josephsvk/IOT_LC_PROTOTYPE_V1/README.md

# IOT_LC_PROTOTYPE_V1

## Requirements typically met:

	- USB Pair > 92.51 ohm Zd
	- AC insulation using 2 mm cutouts in the board; the rest is 3 mm , OVC III, PD2
	- Option to install two different 24V power sources
	- Properly designed GND boards and VIAS , zone minimum width 0.3 mm
	- The area under the antenna connector has been cleaned
	-

Modular IoT controller — custom PCB hardware project designed in KiCad 10.

**Status:** Work in progress — prototype, not validated for production.

This repository contains the KiCad schematic, PCB layout, design rules, and generated technical documentation.

> **Safety:** The design includes mains-voltage circuitry. It has not been certified or validated for safe mains operation. Do not assume that the published design is safe to manufacture or energize.

## Project Files

- `IOT_LC_PROTOTYPE_V1.kicad_pro` — KiCad project configuration
- `IOT_LC_PROTOTYPE_V1.kicad_sch` — Main schematic
- `IOT_LC_PROTOTYPE_V1.kicad_pcb` — PCB layout
- `IOT_LC_PROTOTYPE_V1.kicad_dru` — Custom design rules
- `*.kicad_sch` — Hierarchical schematic sheets

## Automation Scripts

### `scripts/export-pdf.sh`

Generates vector PDF documentation and PNG previews for this README.

```bash
./scripts/export-pdf.sh
```

Requirements: KiCad CLI 10 and `poppler-utils`.

### `scripts/auto-git.sh`

Automatically commits saved project changes and pushes them to GitHub.

- Runs through a local systemd user timer.
- Checks for changes approximately every 15 minutes.
- Respects `.gitignore`.
- Creates commits only when changes exist.
- Does not use force push.

The timer is configured locally and is not installed automatically when cloning this repository.

## Documentation

PDF and PNG files in `docs/` are generated from the KiCad source files.

The README displays PNG previews. The linked PDF files provide vector-quality documentation.

## License

No license has been specified. All rights reserved unless a license is added.

<!-- AUTO-DOCS-START -->
## Schematic documentation

### Complete active hierarchical schematic

**Page 1**

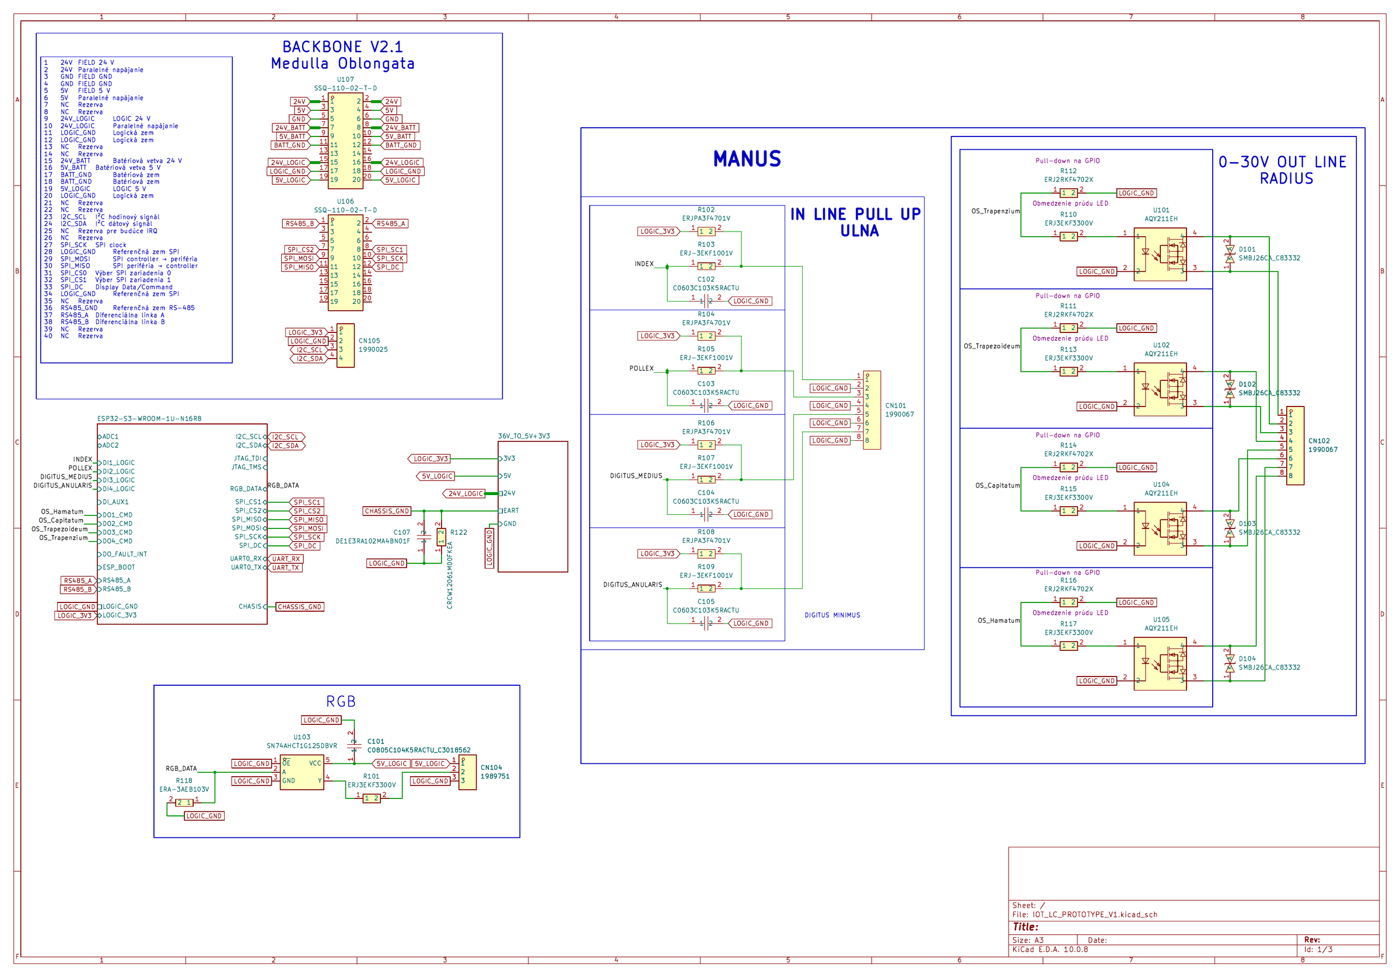
[picture p1: docs/images/schematic-001.png]
Complete active hierarchical schematic — page 1


**Page 2**

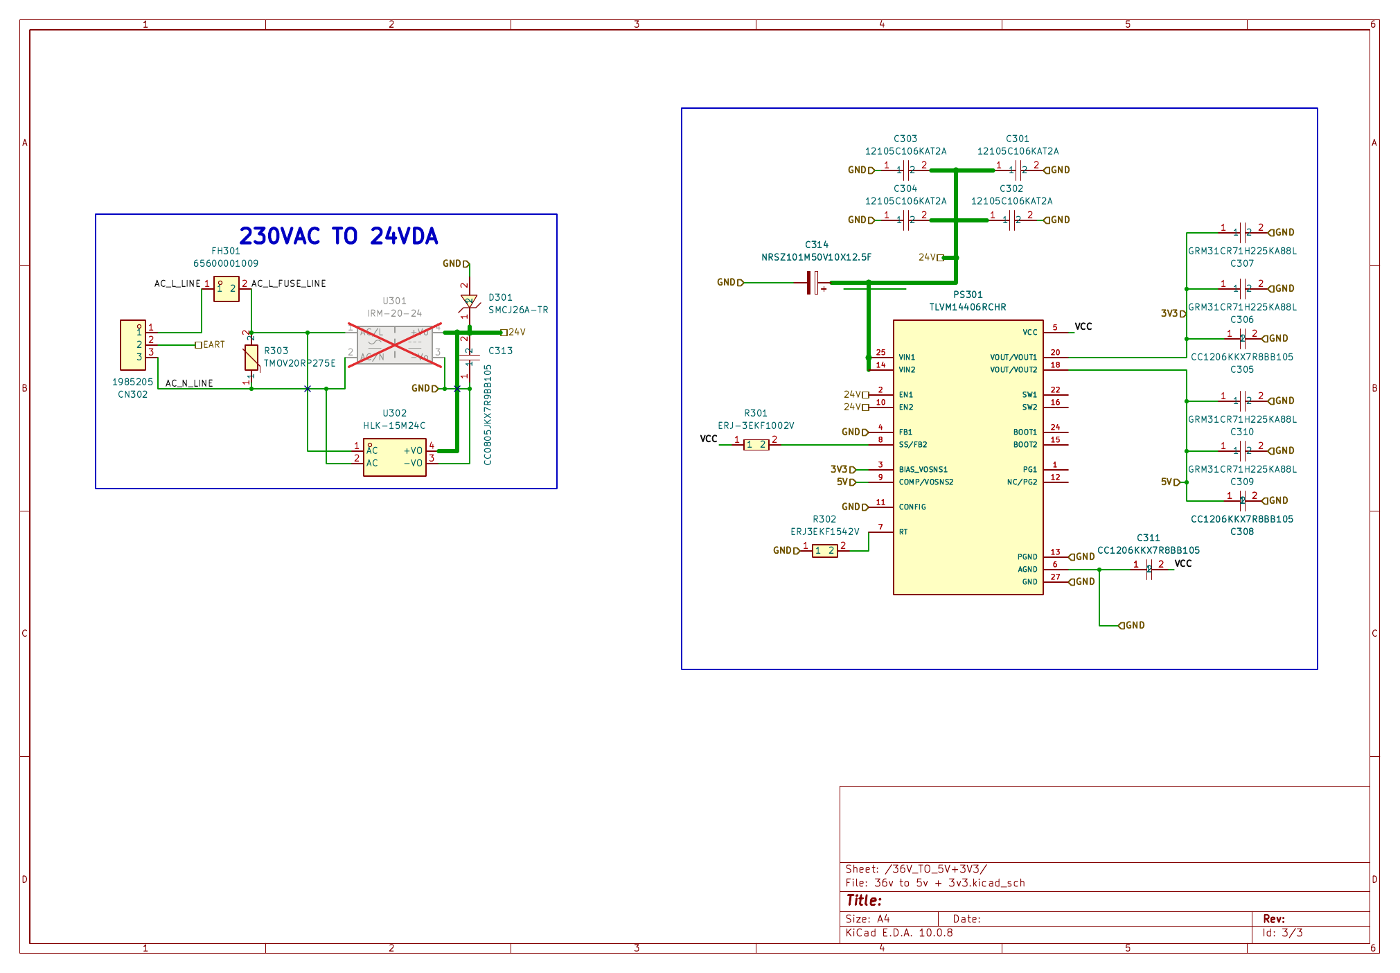
[picture p2: docs/images/schematic-002.png]
Complete active hierarchical schematic — page 2


**Page 3**

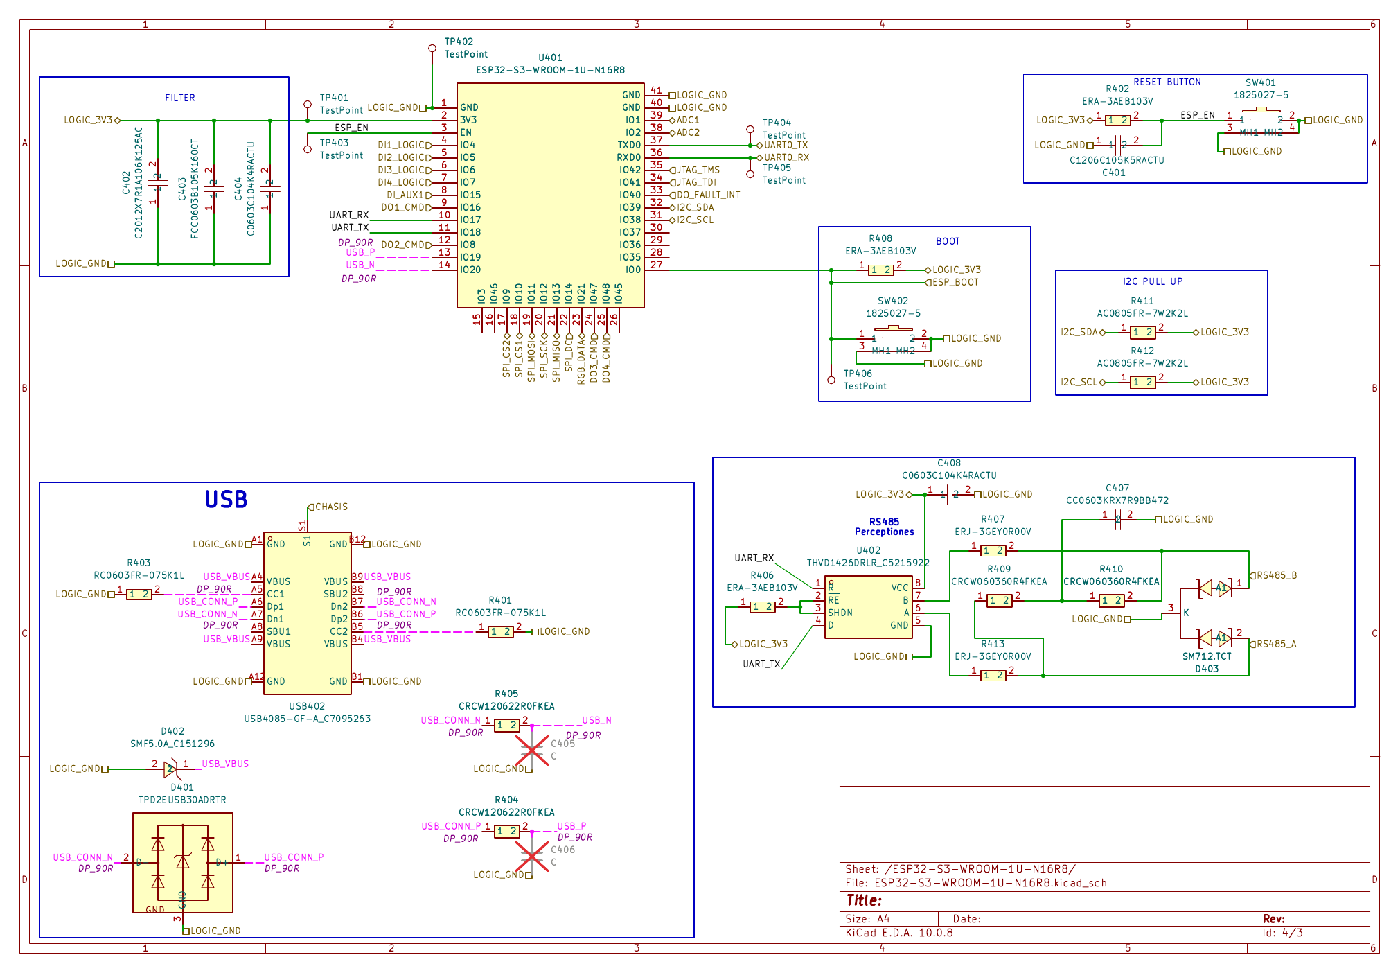
[picture p3: docs/images/schematic-003.png]
Complete active hierarchical schematic — page 3


[View vector PDF](docs/pdf/schematic.pdf)

## PCB documentation

### PCB front

**Page 1**

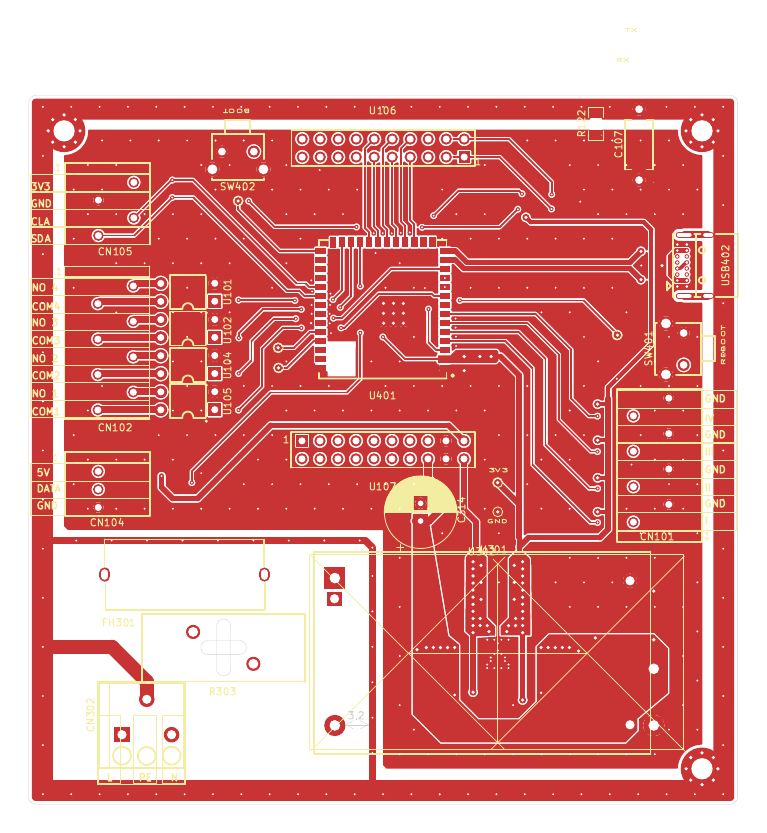
[picture p4: docs/images/pcb-front-001.png]
PCB front — page 1


[View vector PDF](docs/pdf/pcb-front.pdf)

### PCB back

**Page 1**

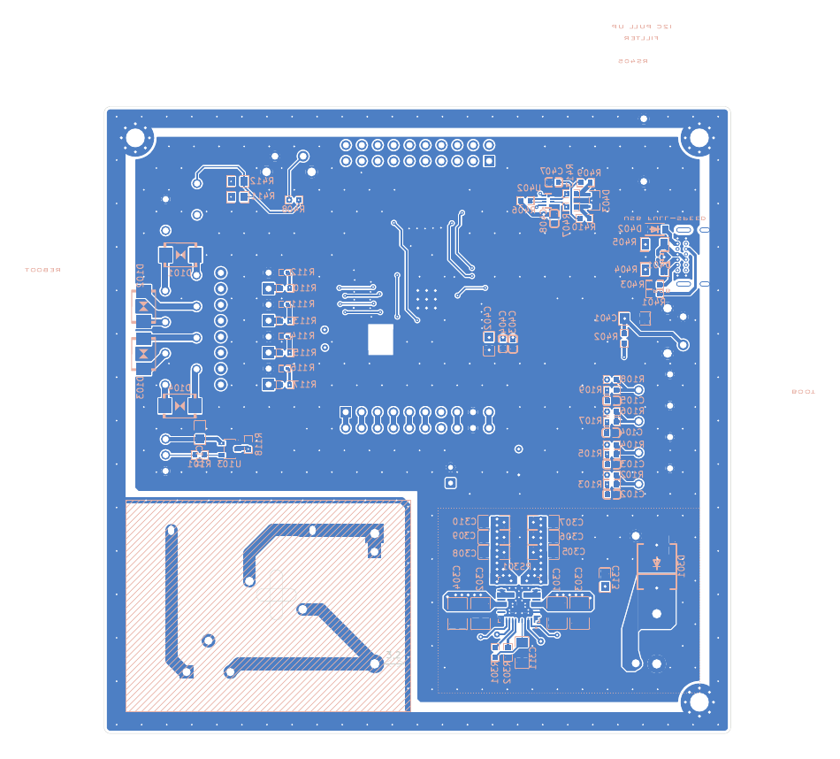
[picture p5: docs/images/pcb-back-001.png]
PCB back — page 1


[View vector PDF](docs/pdf/pcb-back.pdf)

### Individual PCB layers

**Page 1**

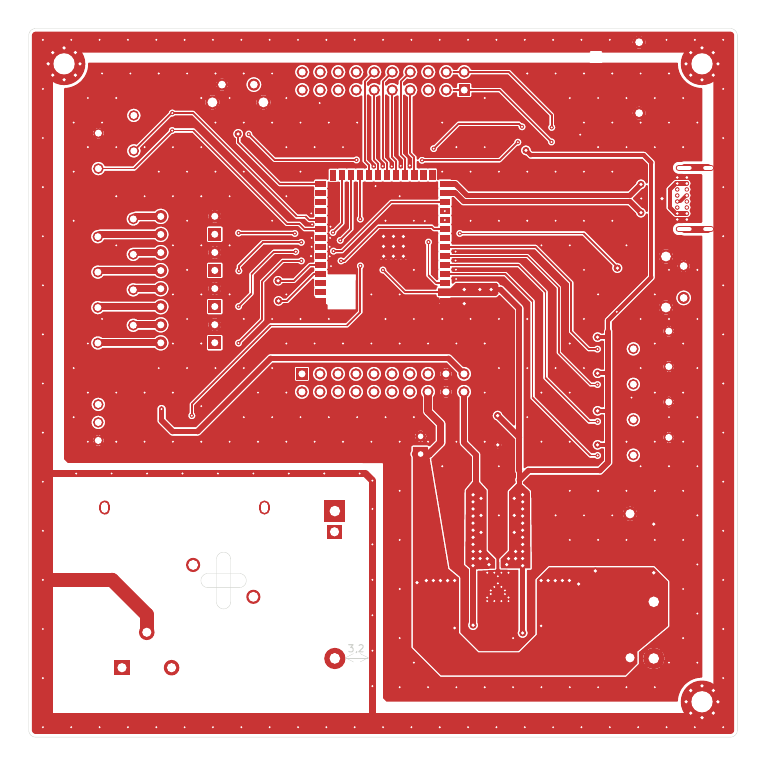
[picture p6: docs/images/pcb-layers-001.png]
Individual PCB layers — page 1


**Page 2**

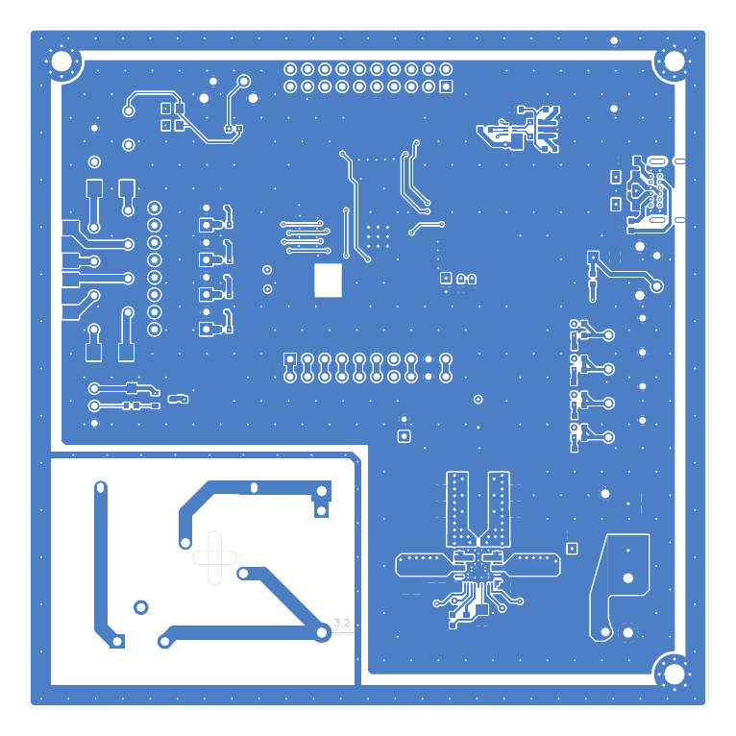
[picture p7: docs/images/pcb-layers-002.png]
Individual PCB layers — page 2


**Page 3**

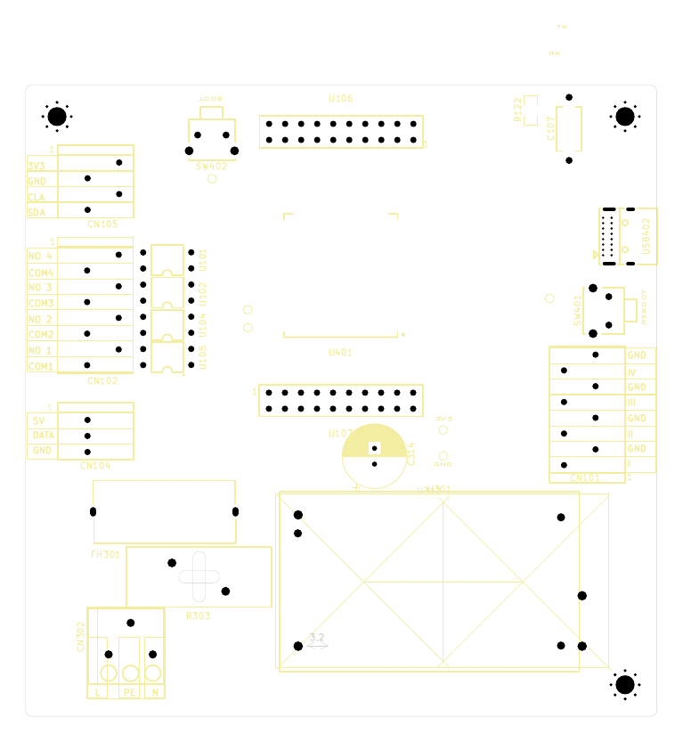
[picture p8: docs/images/pcb-layers-003.png]
Individual PCB layers — page 3


**Page 4**

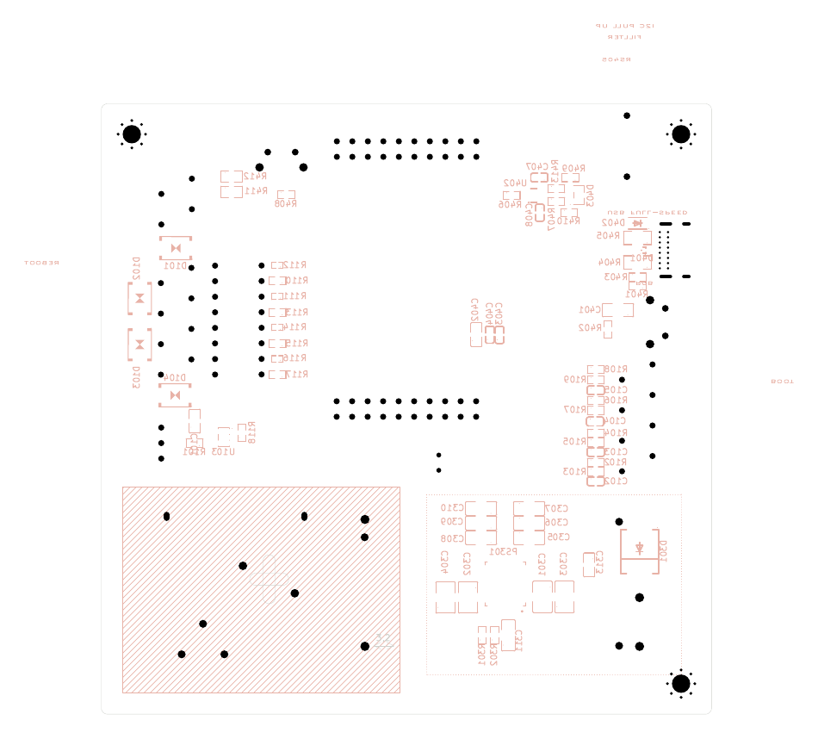
[picture p9: docs/images/pcb-layers-004.png]
Individual PCB layers — page 4


[View vector PDF](docs/pdf/pcb-layers.pdf)
<!-- AUTO-DOCS-END -->
