josephsvk/IOT_LC_PROTOTYPE_V1/pcbway_production/2026-11-04-19-17-19/IOT_LC_PROTOTYPE_V1.kicad_pcb_bom.csv

Designator | Quantity | Value | Footprint | Package | MPN | DNP | Mount_Type | LCSC Part | Manufacturer | Description | MF | MAXIMUM_PACKAGE_HEIGHT | CREATOR | Price | Check_prices | STANDARD | PARTREV | SnapEDA_Link | MP | Availability | MANUFACTURER | label | Label
C101 | 1 | C0805C104K5RACTU_C3018562 | C0805 |  | C0805C104K5RACTU |  | smt | C3018562 | KEMET(基美)
C102, C103, C104, C105 | 4 | C0603C103K5RACTU | C0603 |  | C0603C103K5RACTU |  | smt | C116378 | KEMET(基美)
C301, C302, C303, C304 | 4 | 12105C106KAT2A | C1210 |  | 12105C106KAT2A |  | smt | C597580 | Kyocera AVX
C305, C308, C311 | 3 | CC1206KKX7R8BB105 | C1206 |  | CC1206KKX7R8BB105 |  | tht | C107184 | YAGEO(国巨)
C306, C307, C309, C310 | 4 | GRM31CR71H225KA88L | C1206 |  | GRM31CR71H225KA88L |  | tht | C77095 | muRata(村田) | 2.2uF (225) ±10% 50V
C313 | 1 | CC0805JKX7R9BB105 | C0805 |  | CC0805JKX7R9BB105 |  | smt | C541528 | YAGEO(国巨)
C314 | 1 | NRSZ101M50V10X12.5F | CP_Radial_D10.0mm_P2.50mm |  |  |  | tht |  |  | THT Electrolytic Capacitor, Horizontal Mounting, 12.5mm Diameter, 5.00mm Pitch, 25.0mm Height, European Symbol, Alternate KiCad Library
C401 | 1 | C1206C105K5RACTU | C1206 |  | C1206C105K5RACTU |  | smt | C2167287 | KEMET(基美)
C402 | 1 | C2012X7R1A106K125AC | C0805 |  | C2012X7R1A106K125AC |  | smt | C2167452 | TDK
C403 | 1 | FCC0603B105K160CT | C0603 |  | FCC0603B105K160CT |  | tht | C7419418 | FOJAN(富捷)
C404 | 1 | C0603C104K4RACTU | C0603 |  | C0603C104K4RACTU |  | tht | C2181816 | KEMET(基美)
CN101, CN102 | 2 | 1990067 | CONN-TH_8P-P2.50_1990067 |  | 1990067 |  | tht | C17327671 | Phoenix Contact(菲尼克斯)
CN104 | 1 | 1989751 | CONN-TH_3P-P2.50_1989751 |  | 1989751 |  | tht | C17585029 | Phoenix Contact(菲尼克斯)
CN301 | 1 | 1792876 | CONN-TH_1792876 |  | 1792876 |  | tht | C5482625 | Phoenix Contact(菲尼克斯)
D101, D102, D103, D104 | 4 | SMBJ26CA_C83332 | SMB_L4.6-W3.6-LS5.3-BI |  | SMBJ26CA |  | smt | C83332 | Littelfuse(美国力特)
D301 | 1 | SMCJ26A-TR | SMC_L7.1-W6.2-LS8.1-RD |  | SMCJ26A-TR |  | smt | C133649 | ST(意法半导体)
D401 | 1 | TPD2EUSB30ADRTR | SOT-9X3-3_L1.0-W0.8-P0.35-LS1.0-BR |  | TPD2EUSB30ADRTR |  | smt | C94934 | TI(德州仪器)
D402 | 1 | SMF5.0A_C151296 | SOD-123F_L2.8-W1.8-LS3.7-RD |  | SMF5.0A |  | smt | C151296 | Littelfuse(美国力特)
FH301 | 1 | 65600001009 | FUSE-TH_65600001009 |  | 65600001009 |  | tht | C187510 | Littelfuse(美国力特)
H101 | 1 | M20-6102045 | HDR-TH_40P-P2.54-V-F-R2-C20-S2.54 |  | M20-6102045 |  | tht | C5160231 | Harwin
PS301 | 1 | TLVM14406RCHR | CONV_TLVM14406RCHR | None |  |  | smt |  |  | Non-Isolated PoL Module DC DC Converter 2 Output 0.8 ~ 9V 3A, 3A 3V - 36V Input | Texas Instruments | 2.10mm | NEZY | None | https://www.snapeda.com/parts/TLVM14406RCHR/Texas+Instruments/view-part/?ref=eda | Manufacturer Recommendations | July 2024 | https://www.snapeda.com/parts/TLVM14406RCHR/Texas+Instruments/view-part/?ref=snap | TLVM14406RCHR | In Stock | Texas Instruments
R101, R110, R113, R115, R117 | 5 | ERJ3EKF3300V | R0603 |  | ERJ3EKF3300V |  | smt | C278617 | PANASONIC(松下) |  |  |  |  |  |  |  |  |  |  |  |  | Obmedzenie prúdu LED
R103, R105, R107, R109 | 4 | ERJ-3EKF1001V | R0603 |  | ERJ3EKF1001V |  | smt | C118155 | PANASONIC(松下)
R111, R112, R114, R116 | 4 | ERJ2RKF4702X | R0402 |  | ERJ2RKF4702X |  | smt | C413103 | PANASONIC(松下) |  |  |  |  |  |  |  |  |  |  |  |  | Pull-down na GPIO
R118, R402, R406, R408 | 4 | ERA-3AEB103V | R0603 |  | ERA3AEB103V |  | smt | C190610 | PANASONIC(松下)
R301 | 1 | ERJ-3EKF1002V | R0603 |  | ERJ3EKF1002V |  | smt | C191124 | PANASONIC(松下)
R302 | 1 | ERJ3EKF1542V | R0603 |  | ERJ3EKF1542V |  | smt | C402999 | PANASONIC(松下)
R303 | 1 | TMOV20RP275E | RES-TH_L23.0-W9.5-P8.50-D0.9-S4.50 |  | TMOV20RP275E |  | tht | C187710 | Littelfuse(美国力特)
R401, R403 | 2 | RC0603FR-075K1L | R0603 |  | RC0603FR-075K1L |  | smt | C105580 | YAGEO(国巨)
R404, R405 | 2 | CRCW120622R0FKEA | R1206 |  | CRCW120622R0FKEA |  | tht | C844425 | VISHAY(威世)
R407, R409, R410 | 3 | ERJ-3GEY0R00V | R0603 |  | ERJ3GEY0R00V |  | smt | C122704 | PANASONIC(松下)
R411, R412 | 2 | AC0805FR-7W2K2L | R0805 |  | AC0805FR-7W2K2L |  | smt | C5545398 | YAGEO(国巨)
SW401, SW402 | 2 | 1825027-5 | KEY-TH_4P-L7.5-W6.8-P4.50-LS7.2 |  | 1825027-5 |  | tht | C86476 | TE Connectivity(泰科电子)
TP401, TP402, TP403, TP404, TP405, TP406 | 6 | TestPoint | TestPoint_Pad_D1.0mm |  |  |  | tht |  |  | test point |  |  |  |  |  |  |  |  |  |  |  | GND | [TP401]3V3; [TP403]EN; [TP404]UART0_TX; [TP405]UART0_RX; [TP406]BOOT
U101, U102, U104, U105 | 4 | AQY211EH | DIP-4_L6.4-W4.8-P2.54-LS7.6-BL |  | AQY211EH |  | smt | C719541 | PANASONIC(松下)
U103 | 1 | SN74AHCT1G125DBVR | SOT-23-5_L3.0-W1.7-P0.95-LS2.8-BR |  | SN74AHCT1G125DBVR |  | smt | C7484 | TI(德州仪器)
U302 | 1 | HLK-15M24C | PWRM-TH_4P-L47.5-W28.5_HLK-15MXXC |  | HLK-15M24C |  | tht | C18203066 | HI-LINK(海凌科)
U401 | 1 | ESP32-S3-WROOM-1U-N16R8 | WIRELM-SMD_ESP32-S3-WROOM-1U |  | ESP32-S3-WROOM-1U-N16R8 |  | smt | C3013946 | ESPRESSIF(乐鑫)
U403 | 1 | THVD1450DGKR | VSSOP-8_L3.0-W3.0-P0.65-LS4.9-BL |  | THVD1450DGKR |  | smt | C2860896 | TI(德州仪器)
USB402 | 1 | USB4085-GF-A_C7095263 | USC-C-SMD_USB4085-GF-A |  | USB4085-GF-A |  | tht | C7095263 | GCT
