josephsvk/IOT_LC_PROTOTYPE_V1/IOT_LC_PROTOTYPE_V1-Edge_Cuts.dxf

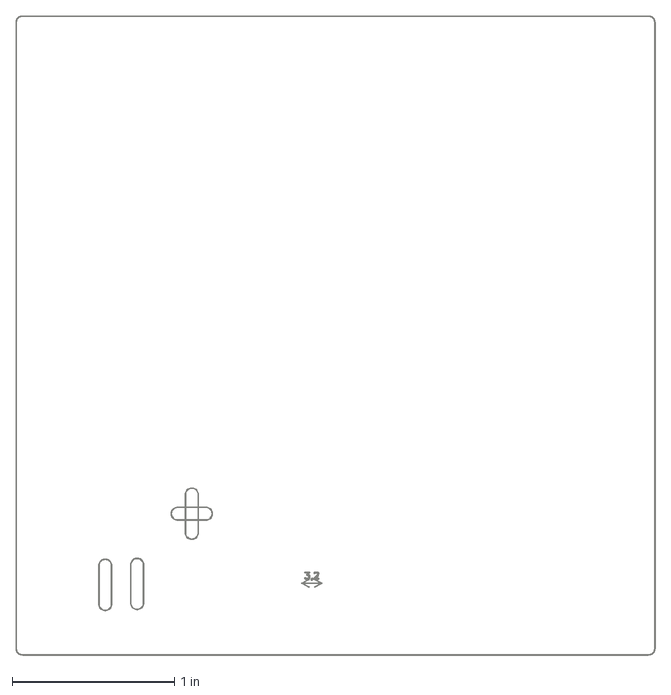
[picture p10: CAD file, 2026-11-07]
IOT_LC_PROTOTYPE_V1-Edge_Cuts.dxf
3.94 x 3.94 in
