josephsvk/IOT_LC_PROTOTYPE_V1/IOT_LC_PROTOTYPE_V1-B_Cu.dxf

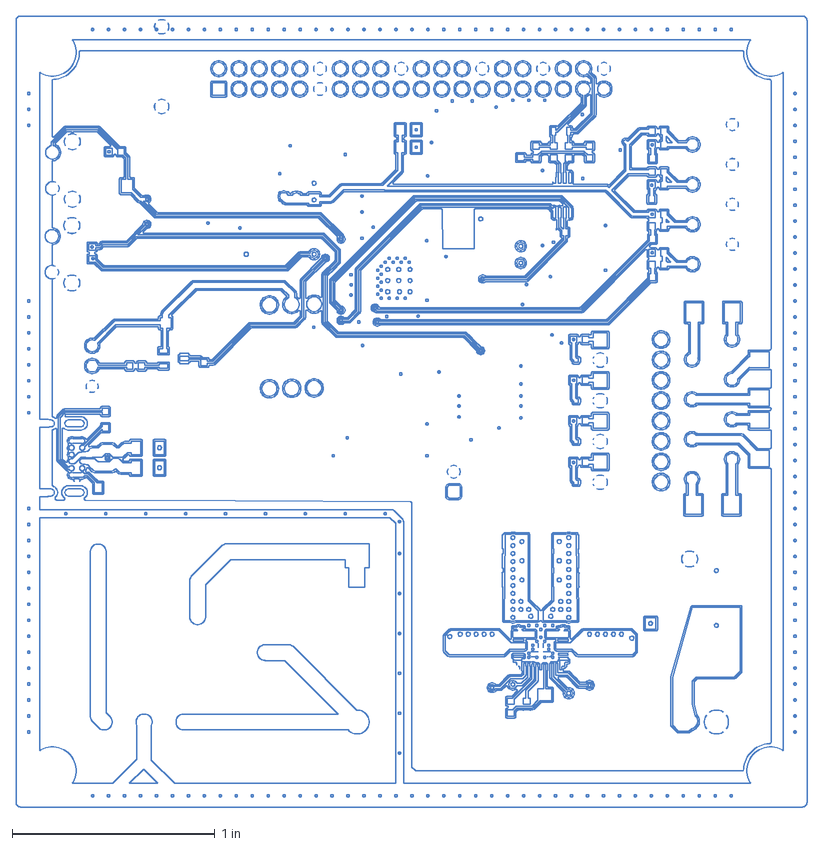
[picture p11: CAD file, 2026-11-07]
IOT_LC_PROTOTYPE_V1-B_Cu.dxf
3.90 x 3.90 in
