josephsvk/IOT_LC_PROTOTYPE_V1/IOT_LC_PROTOTYPE_V1-F_Cu.dxf

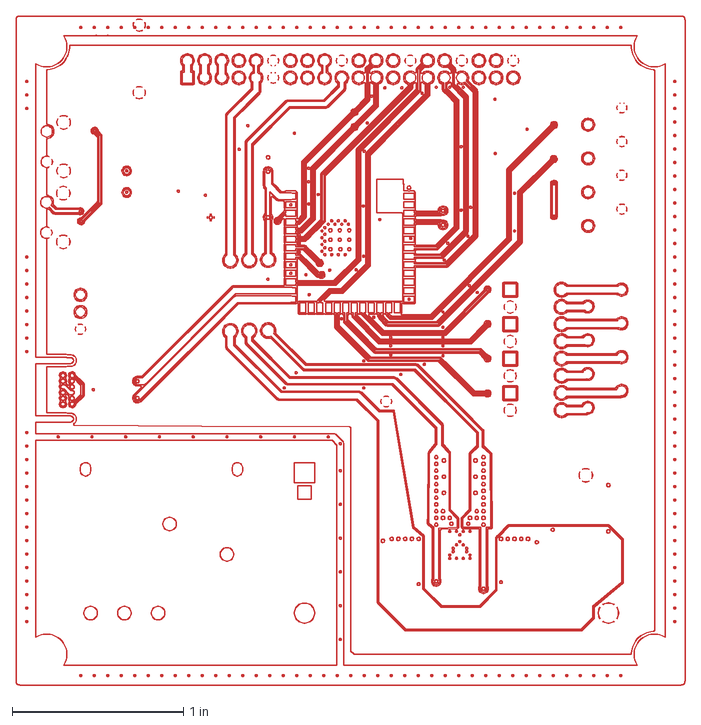
[picture p12: CAD file, 2026-11-07]
IOT_LC_PROTOTYPE_V1-F_Cu.dxf
3.90 x 3.90 in
