josephsvk/IOT_LC_PROTOTYPE_V1/docs/pdf/schematic.pdf

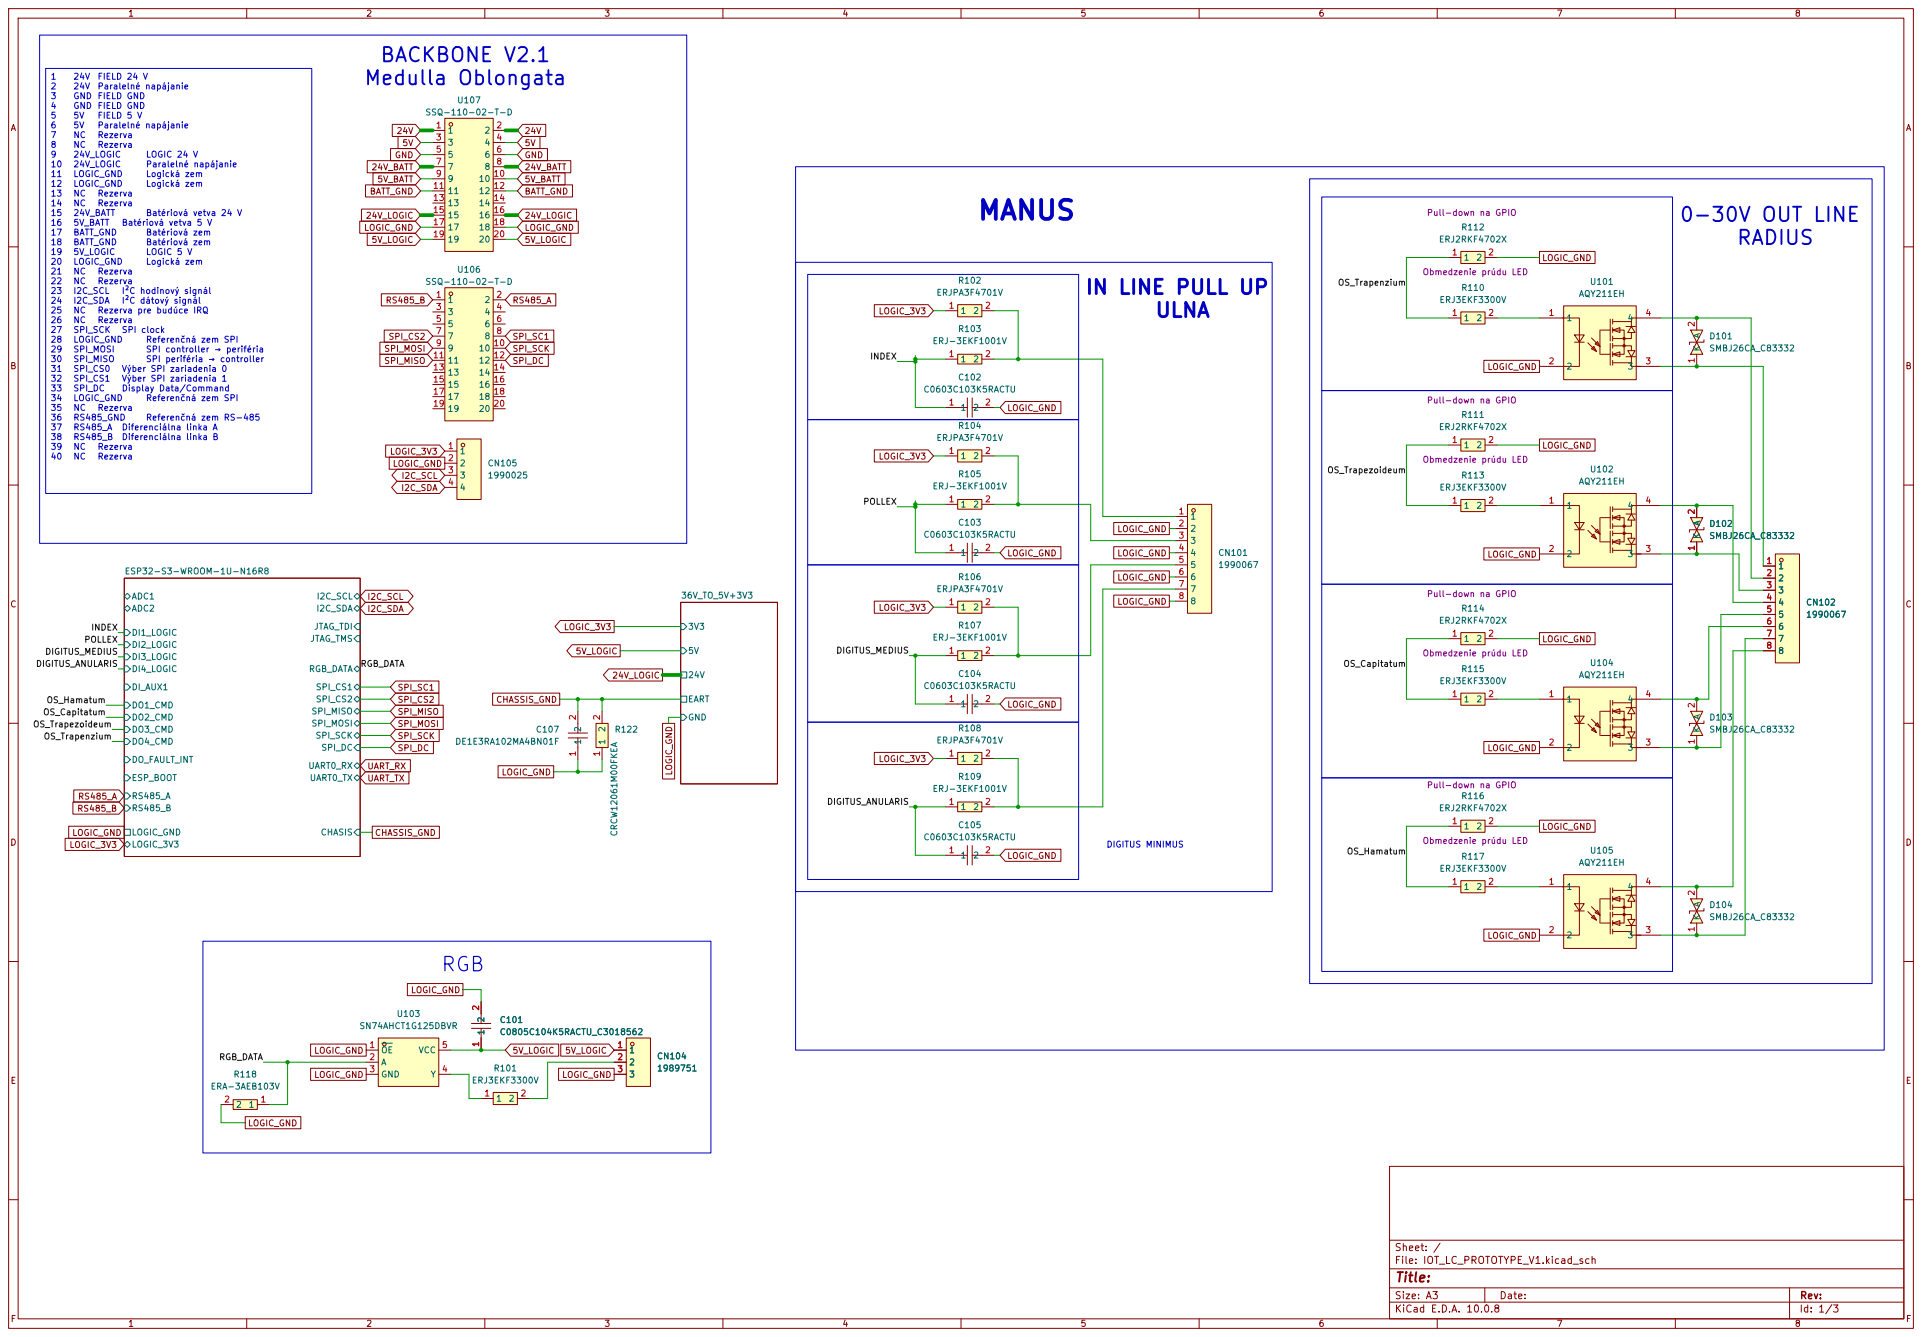
[picture p13: page 1]

ERJ2RKF4702X Pull-down na GPIO

IN LINE PULL UP

37 RS485_A Diferenciálna linka A 38 RS485_B Diferenciálna linka B

Size: A3 | Rev: | F Date:
KiCad E.D.A. 10.0.8 | Id: 1/3

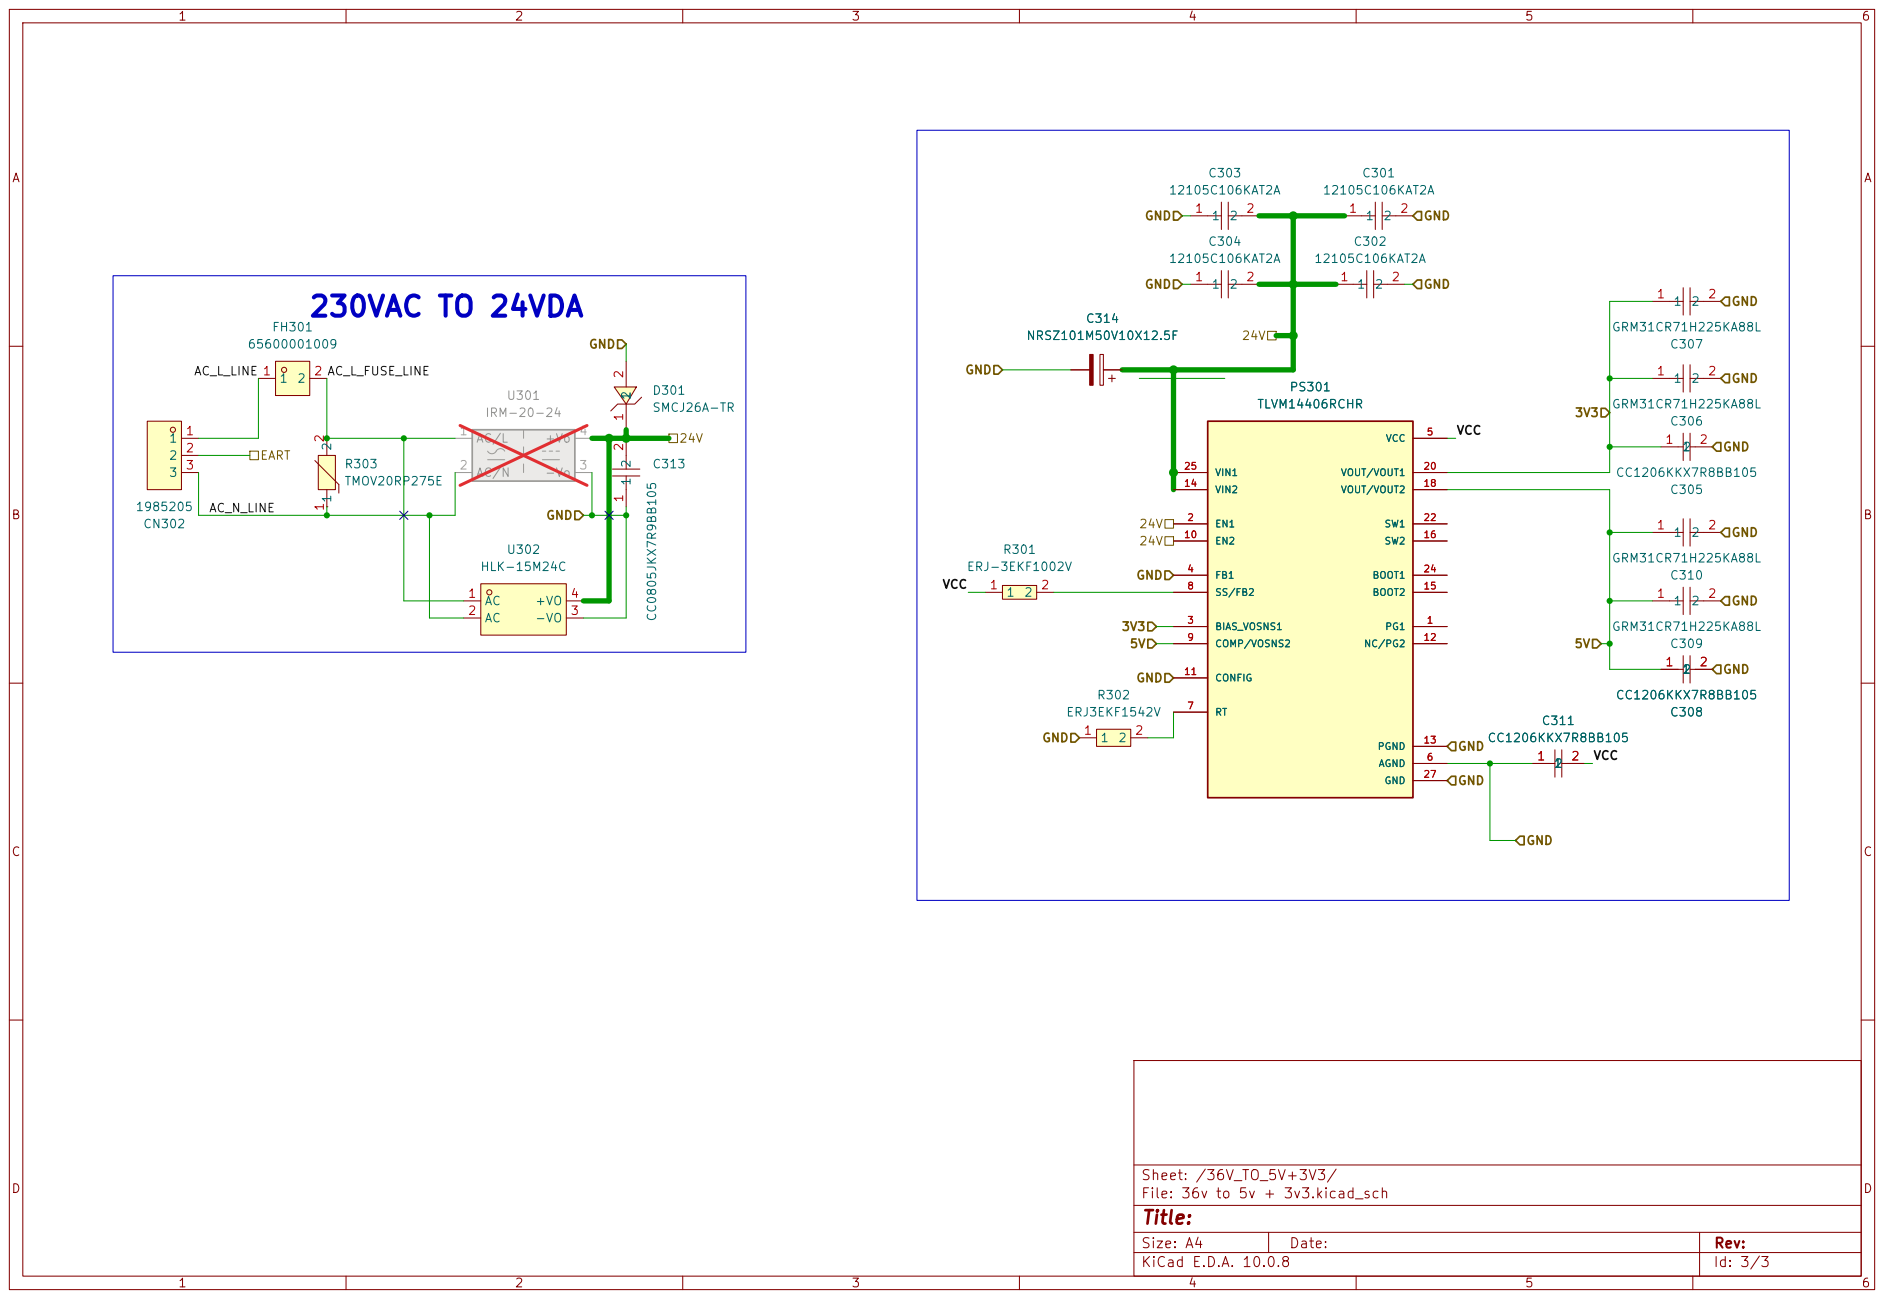
[picture p14: page 2]

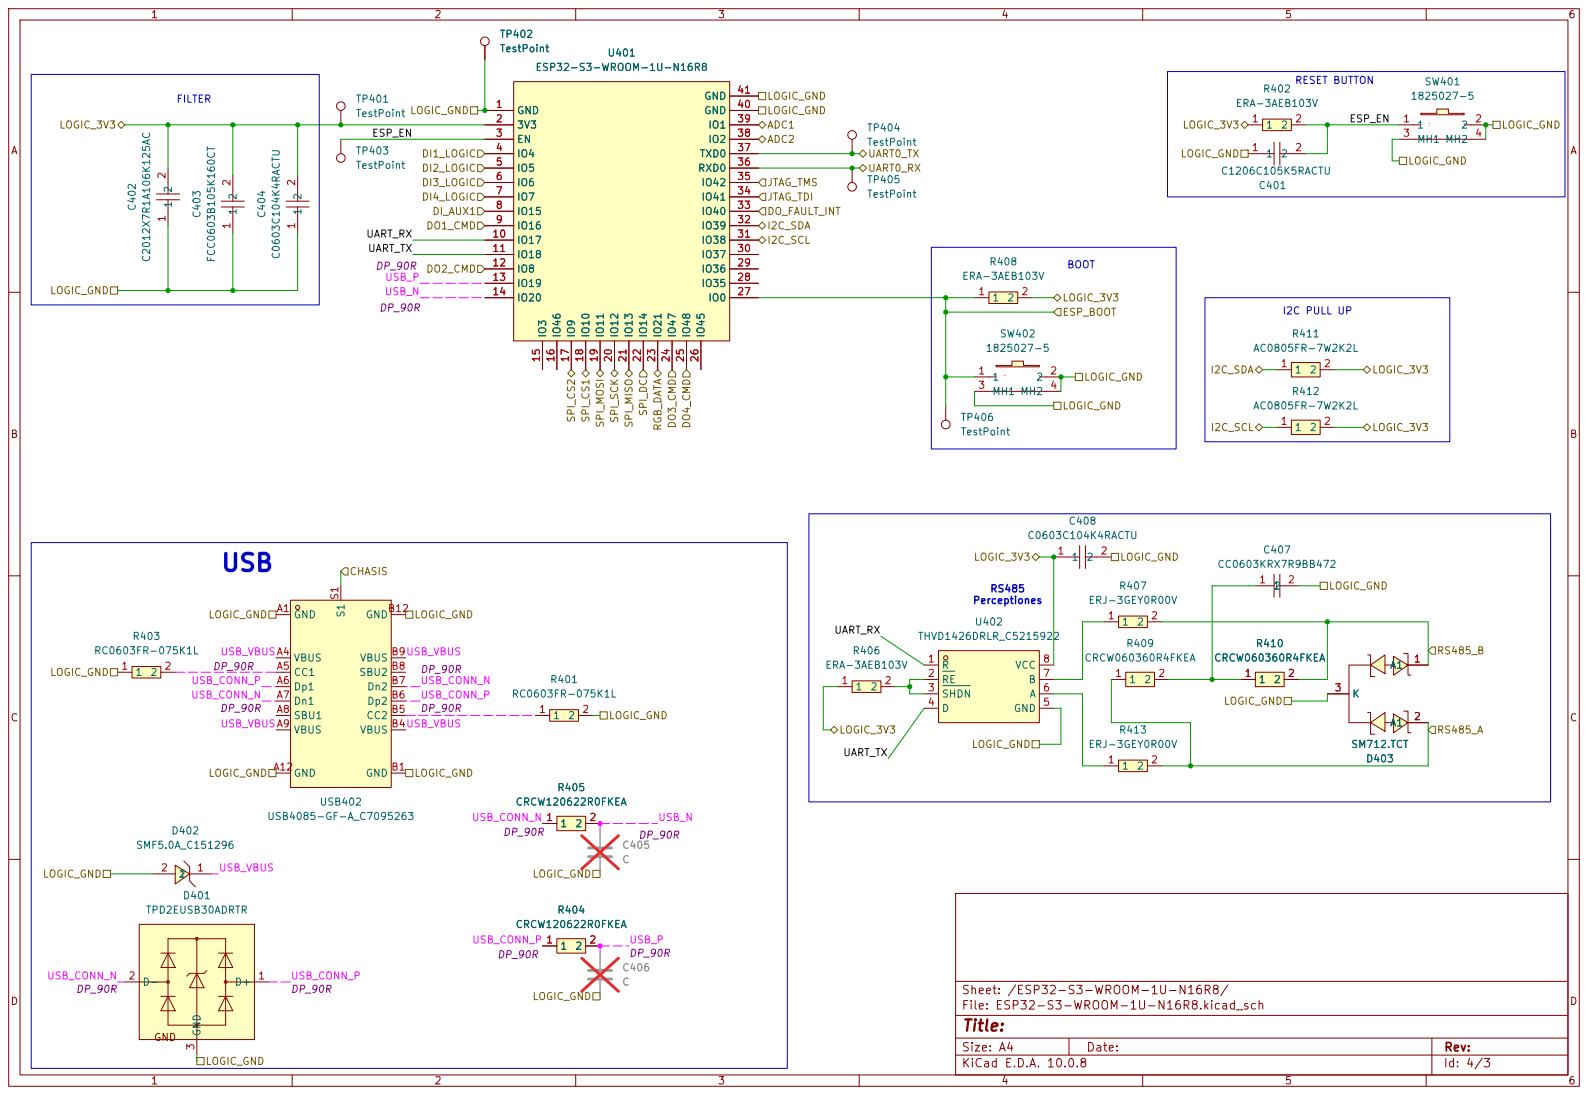
[picture p15: page 3]

2 C408 C0603C104K4RACTU

2 R410 CRCW060360R4FKEA | 3 R410 CRCW060360R4FKEA 1
