josephsvk/IOT_LC_PROTOTYPE_V1/docs/pdf/pcb-front.pdf

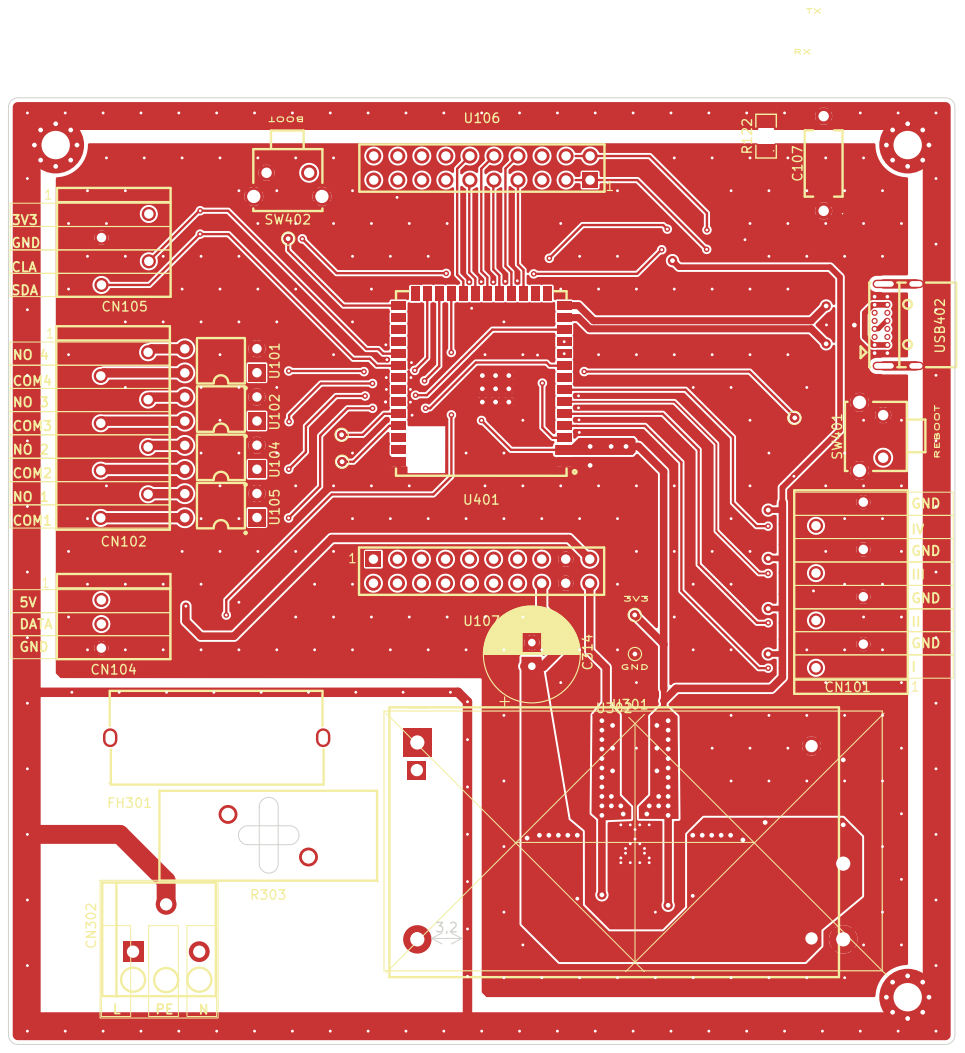
[picture p16: page 1]

3V3 NO 4 COM4 NO 3 COM3 NO 2 COM2 NO 1 COM1

GND

IVGND

III GND
