josephsvk/IOT_LC_PROTOTYPE_V1/docs/pdf/pcb-layers.pdf

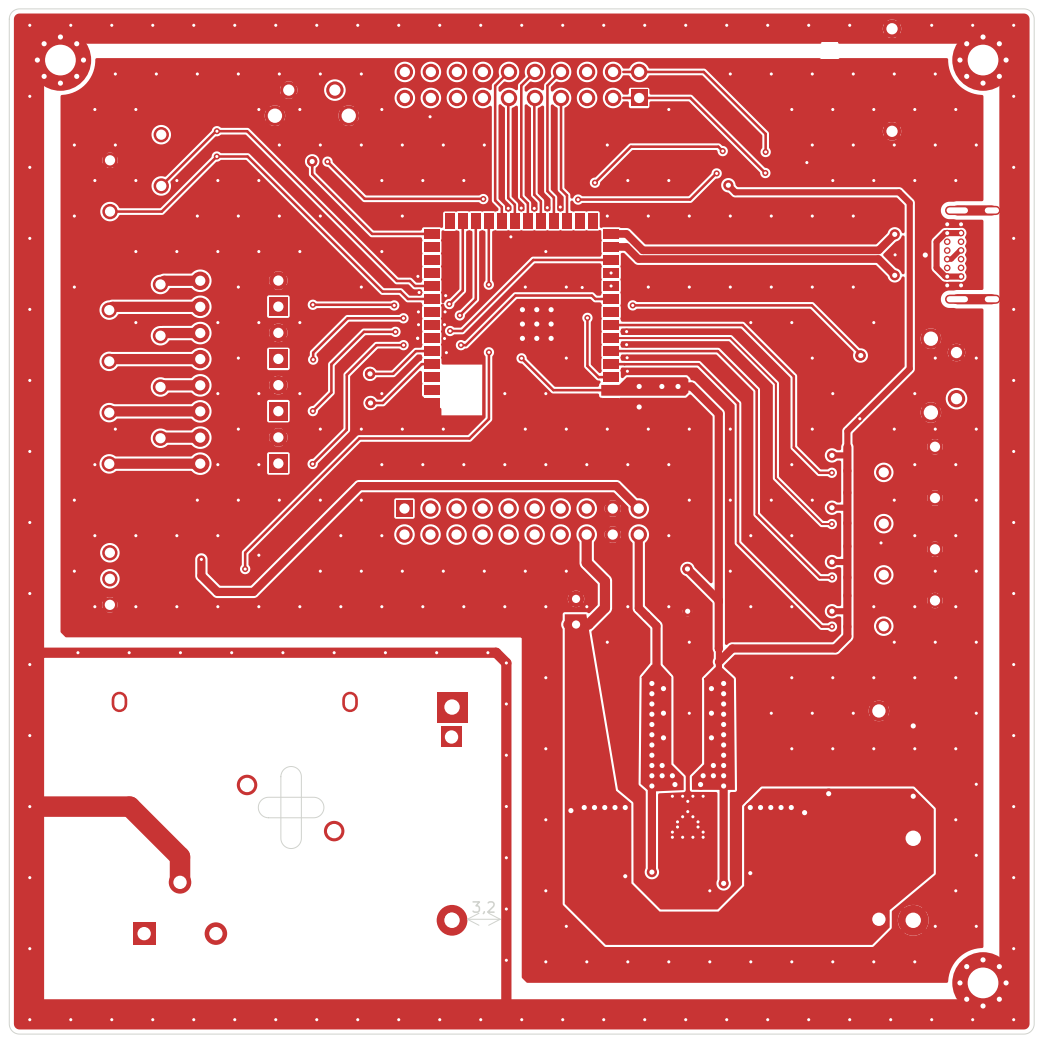
[picture p17: page 1]

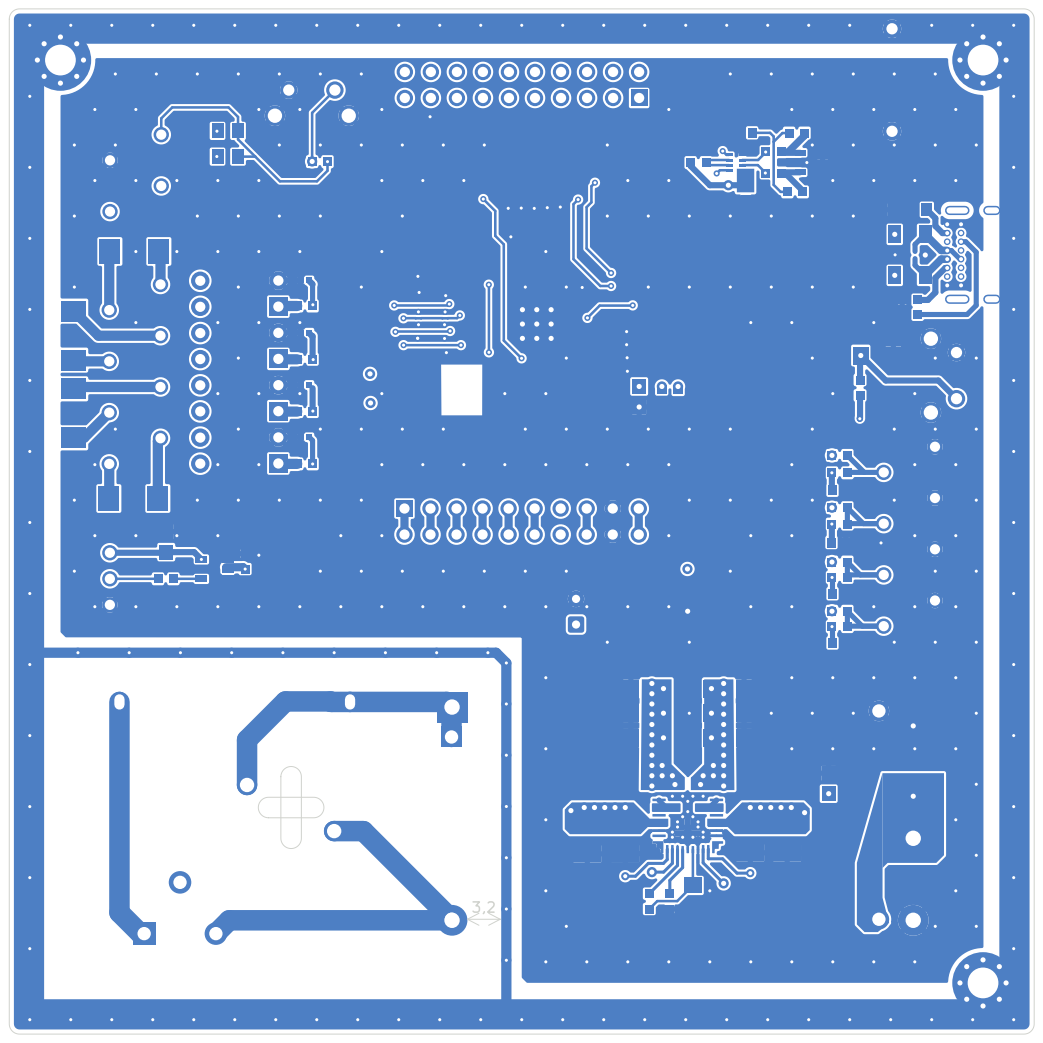
[picture p18: page 2]

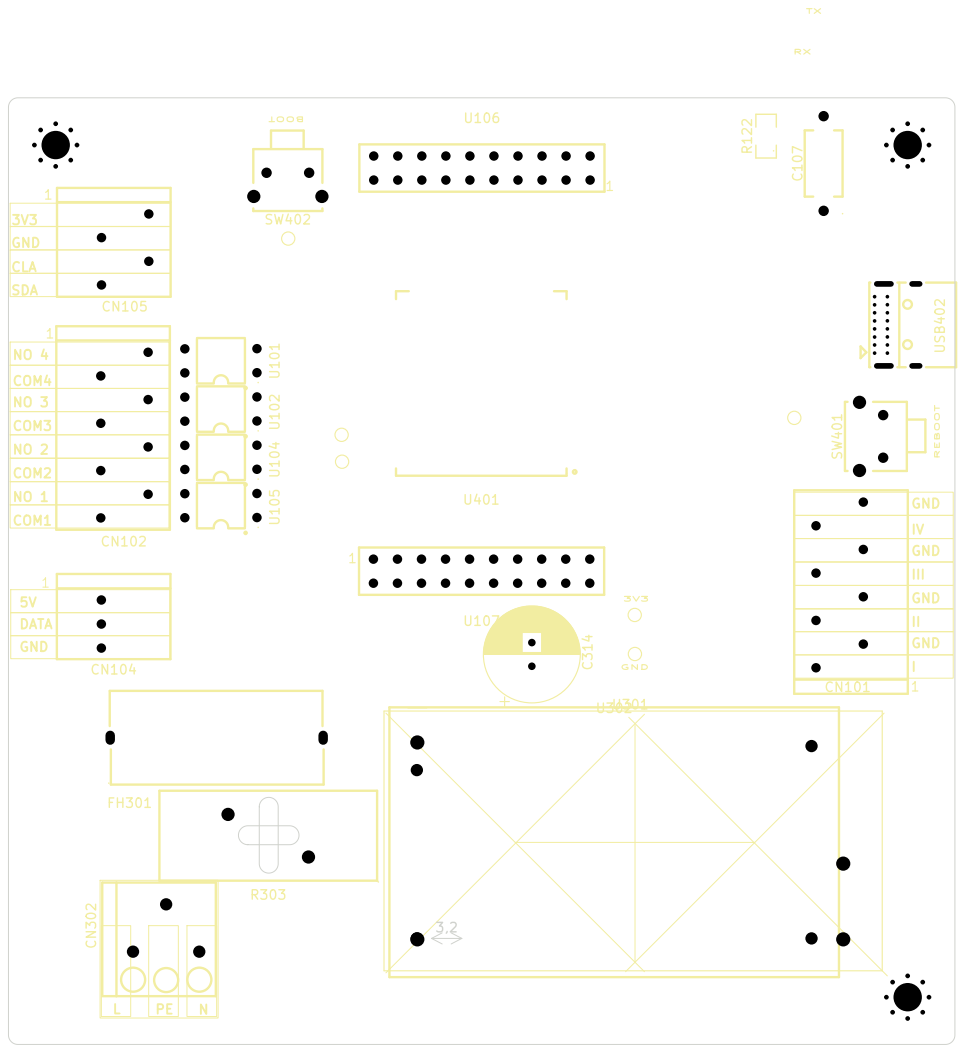
[picture p19: page 3]

3V3 NO 4 COM4 NO 3 COM3 NO 2 COM2 NO 1 COM1

GND

IVGND

III GND

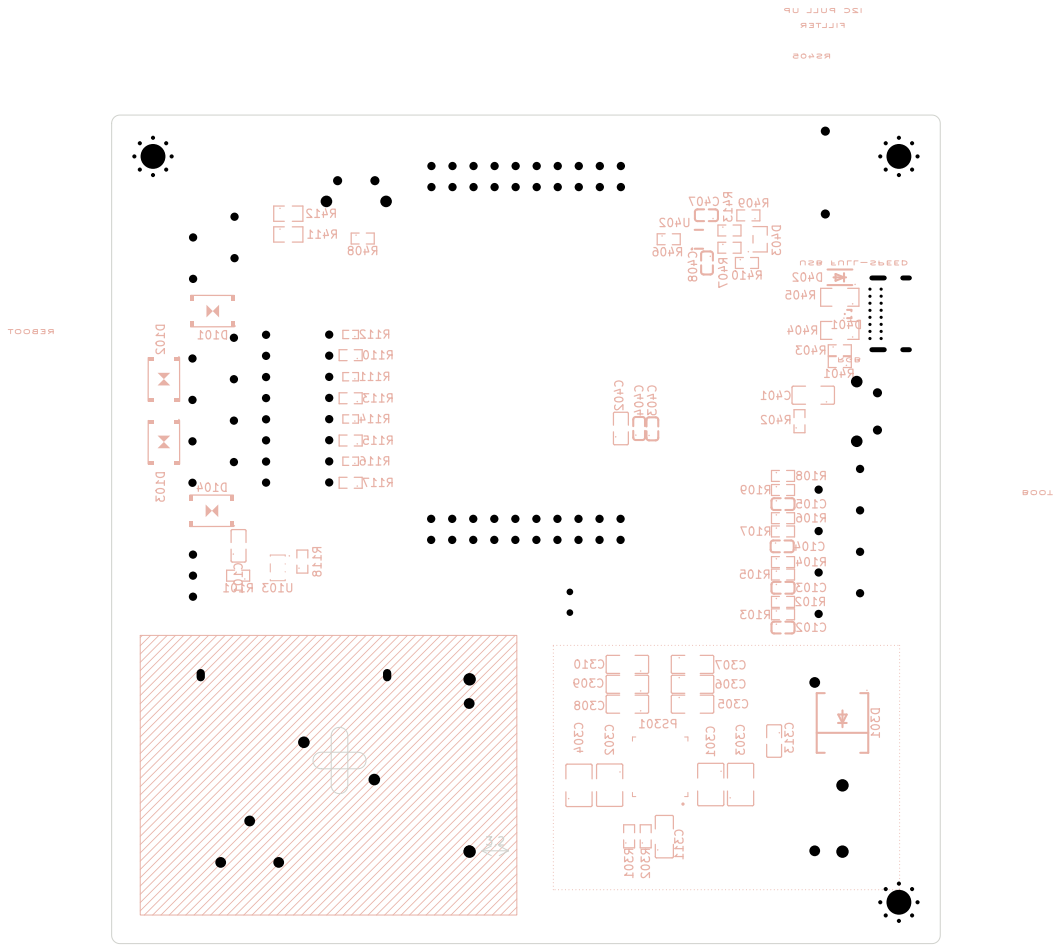
[picture p20: page 4]
