josephsvk/IOT_LC_PROTOTYPE_V1/IOT_LC_PROTOTYPE_V1-B_Cu.pdf

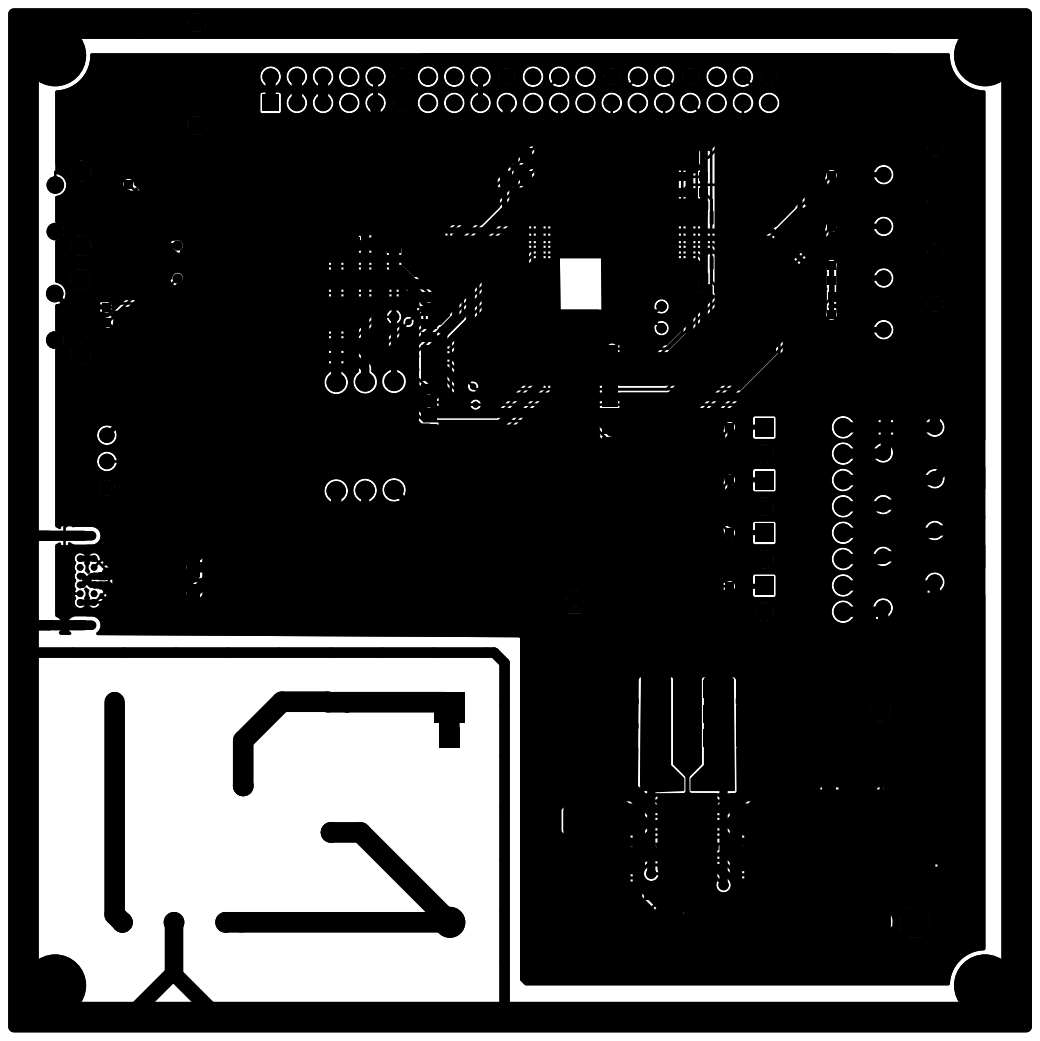
[picture p21: page 1]
