josephsvk/IOT_LC_PROTOTYPE_V1/IOT_LC_PROTOTYPE_V1-Edge_Cuts.pdf

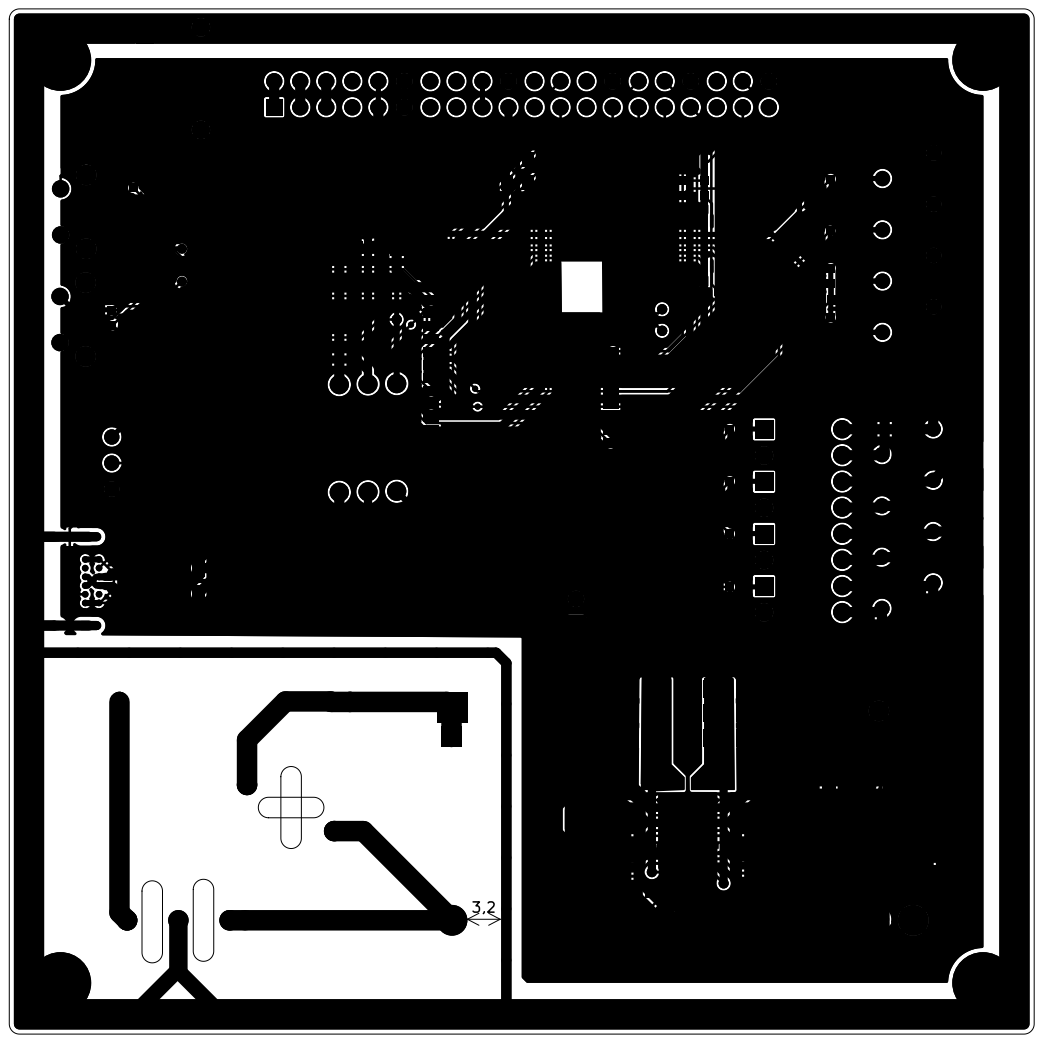
[picture p22: page 1]
