josephsvk/IOT_LC_PROTOTYPE_V1/IOT_LC_PROTOTYPE_V1-F_Cu.pdf

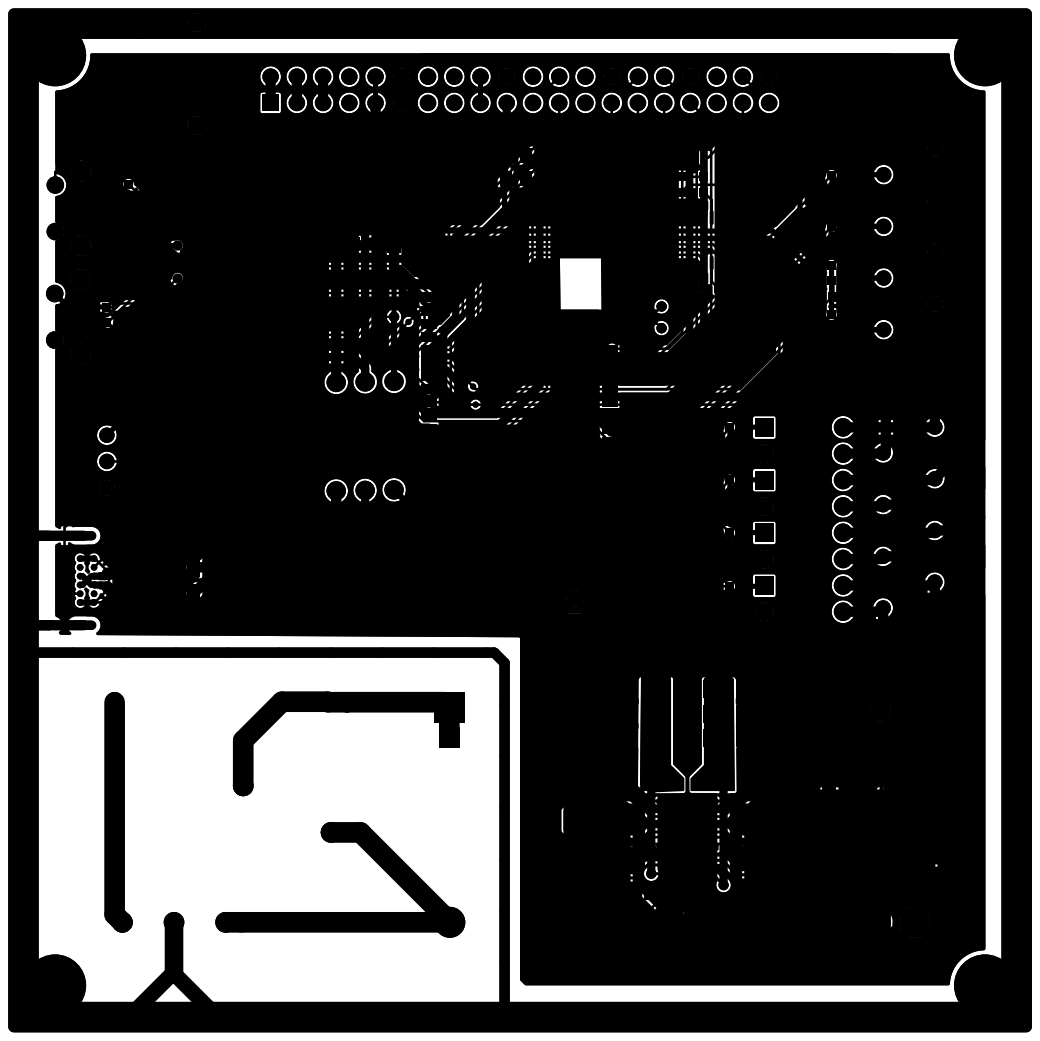
[picture p23: page 1]
