josephsvk/IOT_LC_PROTOTYPE_V1/docs/pdf/pcb-back.pdf

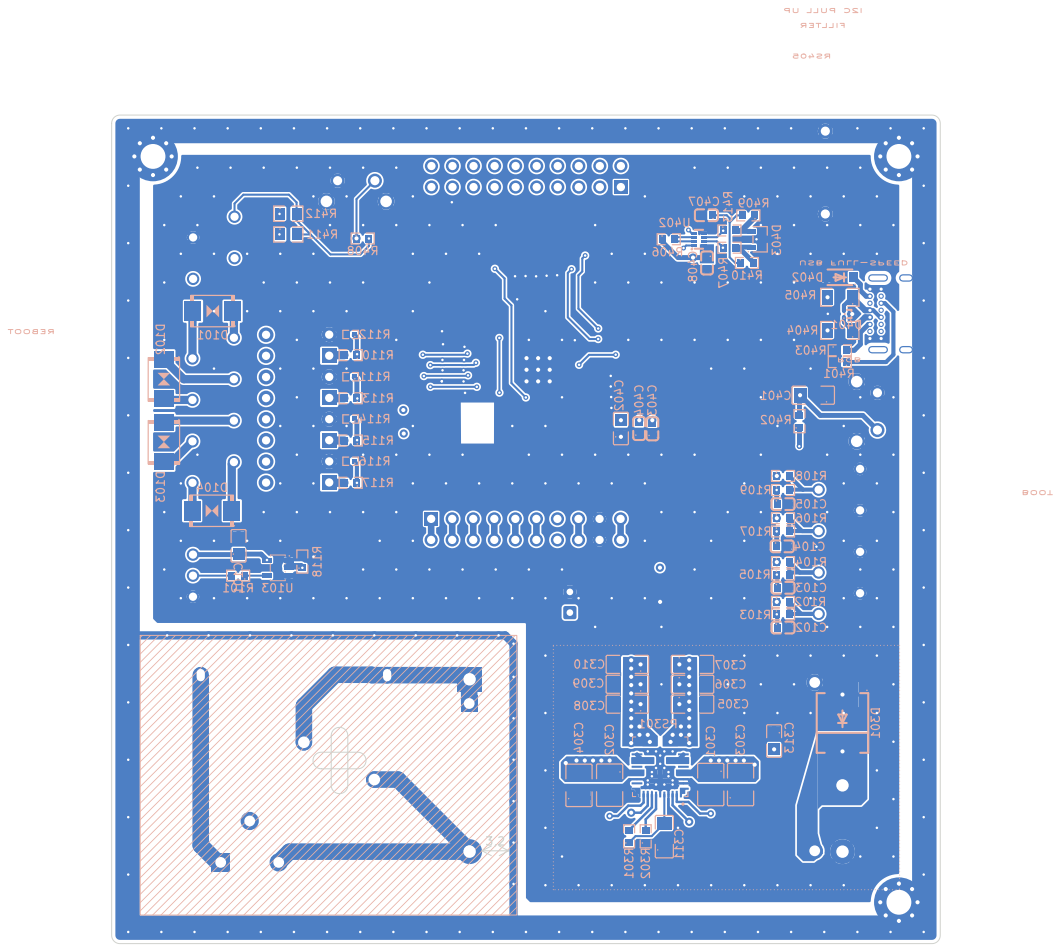
[picture p24: page 1]
