josephsvk/IOT_LC_PROTOTYPE_V1/(list of files, drawings)

Other design files:
sch_data.json
