josephsvk/IOT_LC_PROTOTYPE_V1/IOT_LC_PROTOTYPE_V1.kicad_pcb

## KiCad design IOT_LC_PROTOTYPE_V1.kicad_pcb (2026-11-08)

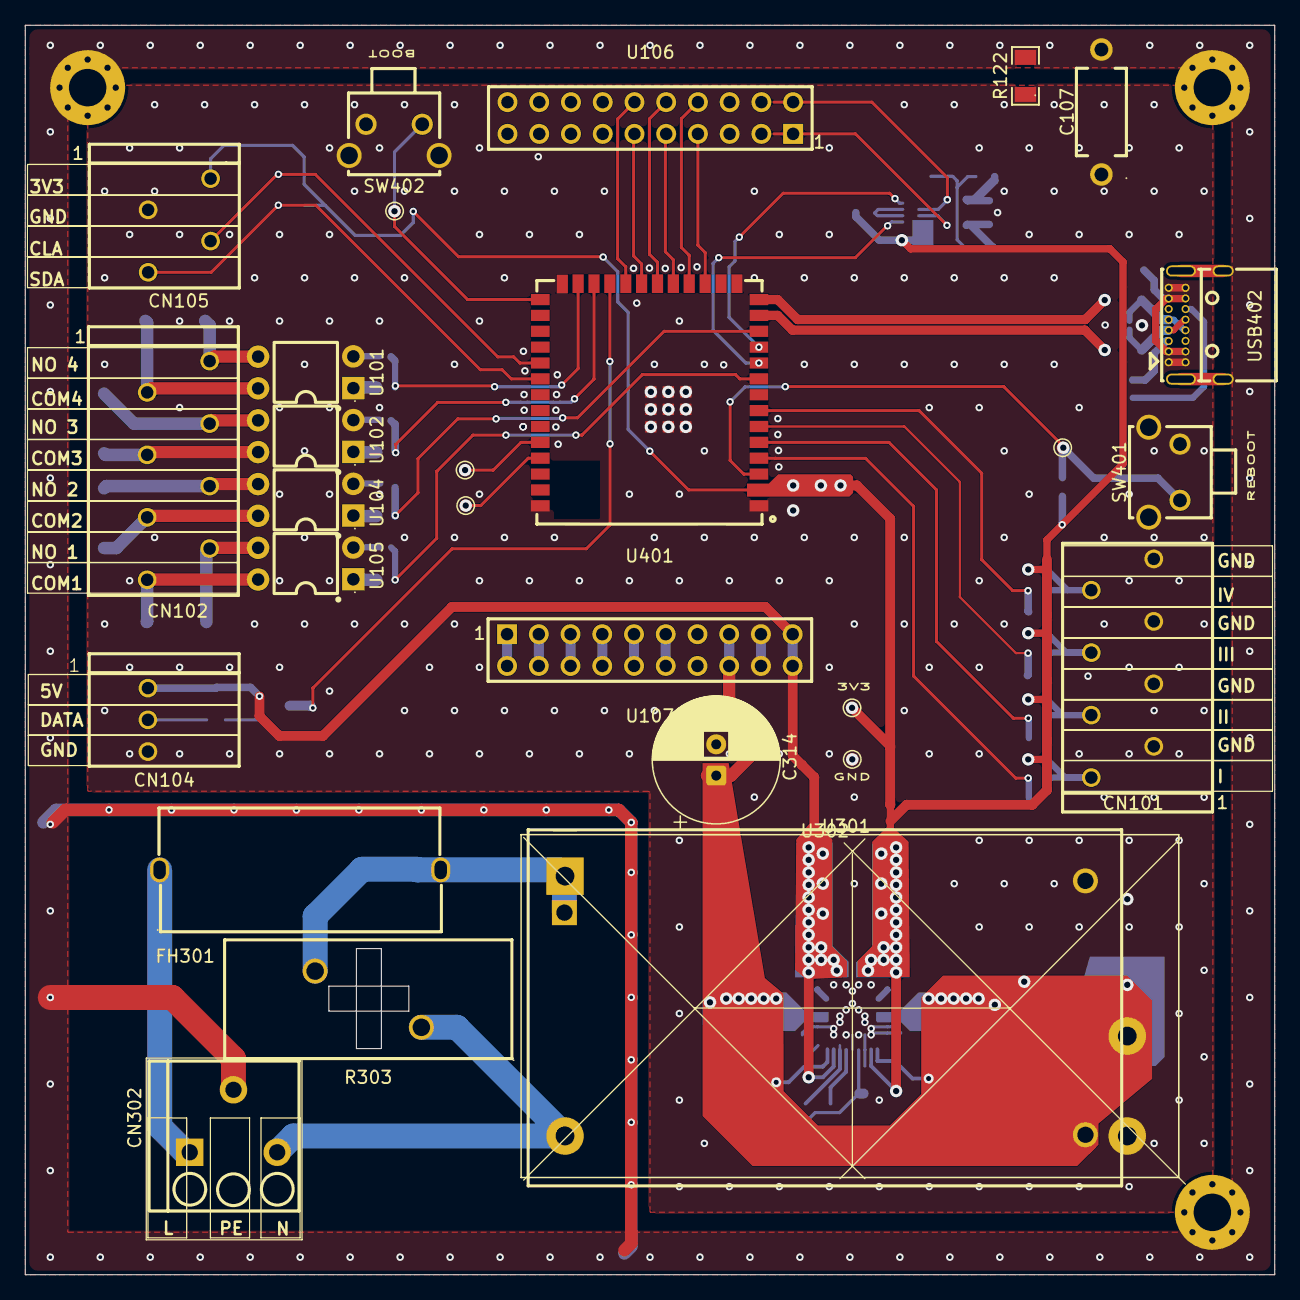
[picture p25: board IOT_LC_PROTOTYPE_V1.kicad_pcb from above]

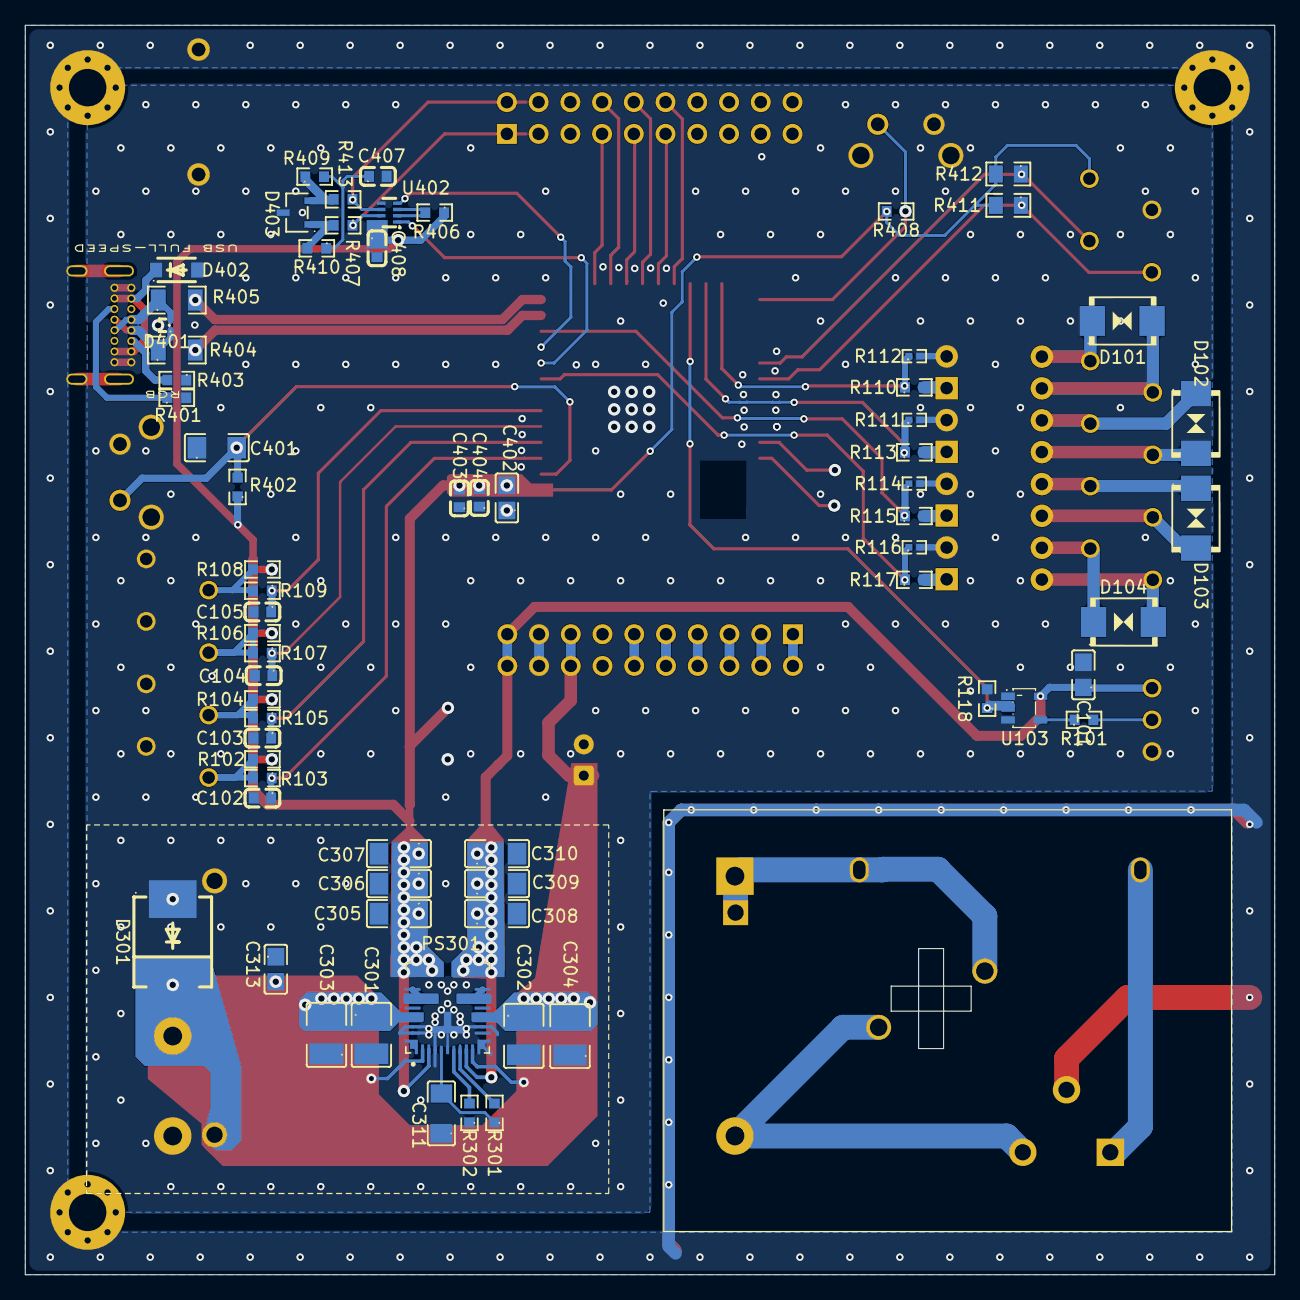
[picture p26: board IOT_LC_PROTOTYPE_V1.kicad_pcb from below]

Board: 2 copper layers, 100.0 x 100.0 mm, 98 parts (67 on the bottom side), 73 nets.

Parts:
C101: C0805C104K5RACTU_C3018562; C0805
C102, C103, C104, C105: C0603C103K5RACTU; C0603
C107: DE1E3RA102MA4BN01F; CAP-TH_L7.0-W4.0-P10.00-D0.6
C301, C302, C303, C304: 12105C106KAT2A; C1210
C305, C308, C311: CC1206KKX7R8BB105; C1206
C306, C307, C309, C310: GRM31CR71H225KA88L; C1206
C313: CC0805JKX7R9BB105; C0805
C314: NRSZ101M50V10X12.5F; CP_Radial_D10.0mm_P2.50mm
C401: C1206C105K5RACTU; C1206
C402: C2012X7R1A106K125AC; C0805
C403: FCC0603B105K160CT; C0603
C404, C408: C0603C104K4RACTU; C0603
C407: CC0603KRX7R9BB472; C0603
CN101, CN102: 1990067; CONN-TH_8P-P2.50_1990067
CN104: 1989751; CONN-TH_3P-P2.50_1989751
CN105: 1990025; CONN-TH_4P-P2.50_1990025
CN302: 1985205; CONN-TH_3P-P3.50_PHOENIX-CONTACT_1985205
D101, D102, D103, D104: SMBJ26CA_C83332; SMB_L4.6-W3.6-LS5.3-BI
D301: SMCJ26A-TR; SMC_L7.1-W6.2-LS8.1-RD
D401: TPD2EUSB30ADRTR; SOT-9X3-3_L1.0-W0.8-P0.35-LS1.0-BR
D402: SMF5.0A_C151296; SOD-123F_L2.8-W1.8-LS3.7-RD
D403: SM712.TCT; SOT-23-3_L3.0-W1.7-P0.95-LS2.9-BR
FH301: 65600001009; FUSE-TH_65600001009
H301, H303, H304: MountingHole_Pad; MountingHole_3mm_Pad_Via
PS301: TLVM14406RCHR; CONV_TLVM14406RCHR
R101, R110, R113, R115, R117: ERJ3EKF3300V; R0603
R102, R104, R106, R108: ERJPA3F4701V; R0603
R103, R105, R107, R109: ERJ-3EKF1001V; R0603
R111, R112, R114, R116: ERJ2RKF4702X; R0402
R118, R402, R406, R408: ERA-3AEB103V; R0603
R122: CRCW12061M00FKEA; R1206
R301: ERJ-3EKF1002V; R0603
R302: ERJ3EKF1542V; R0603
R303: TMOV20RP275E; RES-TH_L23.0-W9.5-P8.50-D0.9-S4.50
R401, R403: RC0603FR-075K1L; R0603
R404, R405: CRCW120622R0FKEA; R1206
R407, R413: ERJ-3GEY0R00V; R0603
R409, R410: CRCW060360R4FKEA; R0603
R411, R412: AC0805FR-7W2K2L; R0805
SW401, SW402: 1825027-5; KEY-TH_4P-L7.5-W6.8-P4.50-LS7.2
TP401, TP402, TP403, TP404, TP405, TP406: TestPoint; TestPoint_Pad_D1.0mm
U101, U102, U104, U105: AQY211EH; DIP-4_L6.4-W4.8-P2.54-LS7.6-BL
U103: SN74AHCT1G125DBVR; SOT-23-5_L3.0-W1.7-P0.95-LS2.8-BR
U106, U107: SSQ-110-02-T-D; HDR-TH_ESQ-110-23-G-D
U301: IRM-20-24; Converter_ACDC_MeanWell_IRM-20-xx_THT
U302: HLK-15M24C; PWRM-TH_4P-L47.5-W28.5_HLK-15MXXC
U401: ESP32-S3-WROOM-1U-N16R8; WIRELM-SMD_ESP32-S3-WROOM-1U
U402: THVD1426DRLR_C5215922; SOT-583-8_L2.1-W1.2-P0.50-LS1.6-BR
USB402: USB4085-GF-A_C7095263; USC-C-SMD_USB4085-GF-A

Connections:
5V: U107.3, U107.4
5V_BATT: U107.9, U107.10
5V_LOGIC: C101.1, C308.1, C309.1, C310.1, CN104.1, PS301.9 (COMP/VOSNS2), PS301.18 (VOUT/VOUT2), PS301.19 (VOUT/VOUT2), U103.5 (VCC), U107.19, U107.20
24V: U107.1, U107.2
24V_BATT: U107.7, U107.8
24V_LOGIC: C301.1, C302.1, C303.2, C304.2, C313.2, C314.1, D301.1, PS301.2 (EN1), PS301.10 (EN2), PS301.14 (VIN2), PS301.25 (VIN1), U107.15, U107.16, U301.4 (+Vo), U302.4 (+VO)
/36V_TO_5V+3V3/AC_L_FUSE_LINE: FH301.2, R303.2, U301.1 (AC/L), U302.1 (AC)
/36V_TO_5V+3V3/AC_L_LINE: CN302.1, FH301.1
/36V_TO_5V+3V3/AC_N_LINE: CN302.3, R303.1, U301.2 (AC/N), U302.2 (AC)
/36V_TO_5V+3V3/VCC: C311.2, PS301.5 (VCC), R301.1
/DIGITUS_ANULARIS: C105.1, R109.1, U401.7 (IO7)
/DIGITUS_MEDIUS: C104.1, R107.1, U401.6 (IO6)
/ESP32-S3-WROOM-1U-N16R8/ESP_BOOT: R408.1, SW402.1, TP406.1 (1_1), U401.27 (IO0)
/ESP32-S3-WROOM-1U-N16R8/ESP_EN: C401.2, R402.2, SW401.1, TP403.1 (1_1), U401.3 (EN)
/ESP32-S3-WROOM-1U-N16R8/UART_RX: U401.10 (IO17), U402.1 (R)
/ESP32-S3-WROOM-1U-N16R8/UART_TX: U401.11 (IO18), U402.4 (D)
/ESP32-S3-WROOM-1U-N16R8/USB_CONN_N: D401.2 (D-), R405.1, USB402.A7 (Dn1), USB402.B7 (Dn2)
/ESP32-S3-WROOM-1U-N16R8/USB_CONN_P: D401.1 (D+), R404.1, USB402.A6 (Dp1), USB402.B6 (Dp2)
/ESP32-S3-WROOM-1U-N16R8/USB_N: R405.2, U401.14 (IO20)
/ESP32-S3-WROOM-1U-N16R8/USB_P: R404.2, U401.13 (IO19)
/ESP32-S3-WROOM-1U-N16R8/USB_VBUS: D402.1, USB402.A4 (VBUS), USB402.A9 (VBUS), USB402.B4 (VBUS), USB402.B9 (VBUS)
/INDEX: C102.1, R103.1, U401.4 (IO4)
/OS_Capitatum: R114.1, R115.1, U401.12 (IO8)
/OS_Hamatum: R116.1, R117.1, U401.9 (IO16)
/OS_Trapenzium: R110.1, R112.1, U401.25 (IO48)
/OS_Trapezoideum: R111.1, R113.1, U401.24 (IO47)
/POLLEX: C103.1, R105.1, U401.5 (IO5)
/RGB_DATA: R118.1, U103.2 (A), U401.23 (IO21)
BATT_GND: U107.11, U107.12
CHASSIS_GND: C107.2, CN302.2, H301.1 (1_1), H303.1 (1_1), H304.1 (1_1), R122.2, USB402.S1
GND: U107.5, U107.6
I2C_SCL: CN105.3, R412.1, U401.31 (IO38)
I2C_SDA: CN105.4, R411.1, U401.32 (IO39)
LOGIC_3V3: C305.1, C306.1, C307.1, C402.2, C403.2, C404.2, C408.1, CN105.1, PS301.3 (BIAS_VOSNS1), PS301.20 (VOUT/VOUT1), PS301.21 (VOUT/VOUT1), R102.1, R104.1, R106.1, R108.1, R402.1, R406.1, R408.2, R411.2, R412.2, TP401.1 (1_1), U401.2 (3V3), U402.8 (VCC)
LOGIC_GND: C101.2, C102.2, C103.2, C104.2, C105.2, C107.1, C301.2, C302.2, C303.1, C304.1, C305.2, C306.2, C307.2, C308.2, C309.2, C310.2, C311.1, C313.1, C314.2, C401.1, C402.1, C403.1, C404.1, C407.2, C408.2, CN101.2, CN101.4, CN101.6, CN101.8, CN104.3, CN105.2, D301.2, D401.3 (GND), D402.2, D403.3 (K), PS301.4 (FB1), PS301.6 (AGND), PS301.11 (CONFIG), PS301.13 (PGND), PS301.26 (PGND), PS301.27 (GND), PS301.28 (PGND), R111.2, R112.2, R114.2, R116.2, R118.2, R122.1, R302.1, R401.2, R403.1, SW401.2, SW401.3 (MH1), SW401.4 (MH2), SW402.2, SW402.3 (MH1), SW402.4 (MH2), TP402.1 (1_1), U101.2, U102.2, U103.1 (~OE), U103.3 (GND), U104.2, U105.2, U107.17, U107.18, U301.3 (-Vo), U302.3 (-VO), U401.1 (GND), U401.40 (GND), U401.41 (GND), U402.5 (GND), USB402.A1 (GND), USB402.A12 (GND), USB402.B1 (GND), USB402.B12 (GND)
unnamed: C407.1, R409.2, R410.1
unnamed: CN101.1, R102.2, R103.2
unnamed: CN101.3, R104.2, R105.2
unnamed: CN101.5, R106.2, R107.2
unnamed: CN101.7, R108.2, R109.2
unnamed: CN104.2, R101.2
unnamed: CN102.2, D101.2 (A), U101.4
unnamed: CN102.1, D101.1 (K), U101.3
unnamed: CN102.4, D102.2 (A), U102.4
unnamed: CN102.3, D102.1 (K), U102.3
unnamed: CN102.6, D103.2 (A), U104.4
unnamed: CN102.5, D103.1 (K), U104.3
unnamed: CN102.8, D104.2 (A), U105.4
unnamed: CN102.7, D104.1 (K), U105.3
unnamed: PS301.7 (RT), R302.2
unnamed: PS301.8 (SS/FB2), R301.2
unnamed: PS301.22 (SW1), PS301.23 (SW1)
unnamed: PS301.16 (SW2), PS301.17 (SW2)
unnamed: R110.2, U101.1
unnamed: R113.2, U102.1
unnamed: R115.2, U104.1
unnamed: R117.2, U105.1
unnamed: R101.1, U103.4 (Y)
unnamed: R413.1, U402.6 (A)
unnamed: R407.1, U402.7 (B)
unnamed: R406.2, U402.2 (~RE), U402.3 (~SHDN)
unnamed: R403.2, USB402.A5 (CC1)
unnamed: R401.1, USB402.B5 (CC2)
RS485_A: D403.2 (A1), R409.1, R413.2, U106.2
RS485_B: D403.1 (A1), R407.2, R410.2, U106.1
SPI_CS2: U106.7, U401.17 (IO9)
SPI_DC: U106.12, U401.22 (IO14)
SPI_MISO: U106.11, U401.21 (IO13)
SPI_MOSI: U106.9, U401.19 (IO11)
SPI_SC1: U106.8, U401.18 (IO10)
SPI_SCK: U106.10, U401.20 (IO12)
UART_RX: TP405.1 (1_1), U401.36 (RXD0)
UART_TX: TP404.1 (1_1), U401.37 (TXD0)
