josephsvk/IOT_LC_PROTOTYPE_V1/(commit log)

2026-11-04 Initial KiCad PCB project
    [5V_TO_3V3.kicad_sch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]
2026-11-04 Clean KiCad repository and add gitignore
    [IOT_LC_PROTOTYPE_V1-B_Cu.gbr, IOT_LC_PROTOTYPE_V1-B_Mask.gbr, IOT_LC_PROTOTYPE_V1-B_Paste.gbr, IOT_LC_PROTOTYPE_V1-B_Silkscreen.gbr, IOT_LC_PROTOTYPE_V1-Edge_Cuts.gbr, IOT_LC_PROTOTYPE_V1-F_Cu.gbr, IOT_LC_PROTOTYPE_V1-F_Mask.gbr, IOT_LC_PROTOTYPE_V1-F_Paste.gbr]
2026-11-04 Add dynamic schematic gallery and cropped PCB previews
2026-11-04 Show only active KiCad schematic hierarchy
2026-11-04 Auto backup: 2026-11-04 09:39:47
    [IOT_LC_PROTOTYPE_V1.kicad_pcb]
2026-11-04 Auto backup: 2026-11-04 09:54:59
    [IOT_LC_PROTOTYPE_V1.kicad_pcb]
2026-11-04 Auto backup: 2026-11-04 11:53:23
    [IOT_LC_PROTOTYPE_V1.kicad_pcb]
2026-11-04 Auto backup: 2026-11-04 12:55:27
    [IOT_LC_PROTOTYPE_V1.kicad_pcb]
2026-11-04 Auto backup: 2026-11-04 13:26:23
    [IOT_LC_PROTOTYPE_V1.kicad_pcb, IOT_LC_PROTOTYPE_V1.kicad_sch]
2026-11-04 Auto backup: 2026-11-04 17:22:36
    [IOT_LC_PROTOTYPE_V1.kicad_pcb]
2026-11-04 Auto backup: 2026-11-04 18:24:46
    [IOT_LC_PROTOTYPE_V1.kicad_pcb]
2026-11-04 Auto backup: 2026-11-04 19:11:37
    [IOT_LC_PROTOTYPE_V1.kicad_pcb]
2026-11-04 Auto backup: 2026-11-04 19:24:18
    [IOT_LC_PROTOTYPE_V1.kicad_pcb_bom.csv, IOT_LC_PROTOTYPE_V1.kicad_pcb_positions.csv]
2026-11-04 Auto backup: 2026-11-04 23:53:30
    [IOT_LC_PROTOTYPE_V1.kicad_pcb]
2026-11-05 Auto backup: 2026-11-05 17:55:12
    [IOT_LC_PROTOTYPE_V1.kicad_pcb]
2026-11-06 Auto backup: 2026-11-06 11:42:23
    [IOT_LC_PROTOTYPE_V1.kicad_pcb]
2026-11-06 Auto backup: 2026-11-06 12:14:23
    [IOT_LC_PROTOTYPE_V1.kicad_pcb]
2026-11-06 Auto backup: 2026-11-06 13:16:27
    [IOT_LC_PROTOTYPE_V1.kicad_sch]
2026-11-06 Auto backup: 2026-11-06 13:32:21
    [IOT_LC_PROTOTYPE_V1.kicad_pcb, IOT_LC_PROTOTYPE_V1.kicad_sch]
2026-11-06 Auto backup: 2026-11-06 13:48:23
    [IOT_LC_PROTOTYPE_V1.kicad_pcb, IOT_LC_PROTOTYPE_V1.kicad_sch]
2026-11-06 Auto backup: 2026-11-06 14:03:40
    [IOT_LC_PROTOTYPE_V1.kicad_sch]
2026-11-06 Auto backup: 2026-11-06 14:34:39
    [IOT_LC_PROTOTYPE_V1.kicad_pcb]
2026-11-06 Auto backup: 2026-11-06 15:36:26
    [IOT_LC_PROTOTYPE_V1.kicad_pcb]
2026-11-07 Auto backup: 2026-11-07 12:42:25
    [IOT_LC_PROTOTYPE_V1.kicad_pcb, IOT_LC_PROTOTYPE_V1.kicad_sch]
2026-11-07 Auto backup: 2026-11-07 17:29:34
    [IOT_LC_PROTOTYPE_V1.kicad_pcb]
2026-11-07 Auto backup: 2026-11-07 17:44:51
    [IOT_LC_PROTOTYPE_V1.kicad_sch]
2026-11-07 Auto backup: 2026-11-07 18:31:15
    [IOT_LC_PROTOTYPE_V1.kicad_sch]
2026-11-07 Auto backup: 2026-11-07 19:49:02
    [IOT_LC_PROTOTYPE_V1-B_Cu.dxf, IOT_LC_PROTOTYPE_V1-Edge_Cuts.dxf, IOT_LC_PROTOTYPE_V1-F_Cu.dxf]
2026-11-07 Auto backup: 2026-11-07 20:35:35
    [IOT_LC_PROTOTYPE_V1.kicad_pcb]
2026-11-08 Auto backup: 2026-11-09 00:24:22
    [IOT_LC_PROTOTYPE_V1.kicad_pcb, IOT_LC_PROTOTYPE_V1.kicad_sch]
